byxlk/mcupj/docs/微信图片_20210222200703.jpg

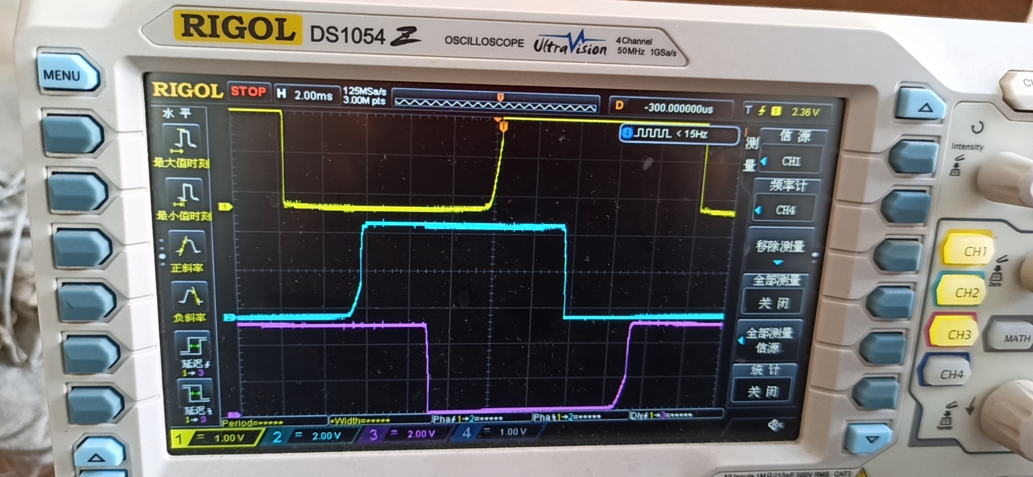
docs/微信图片_20210222200703.jpg
