byxlk/mcupj/docs/微信图片_20210222200711.jpg

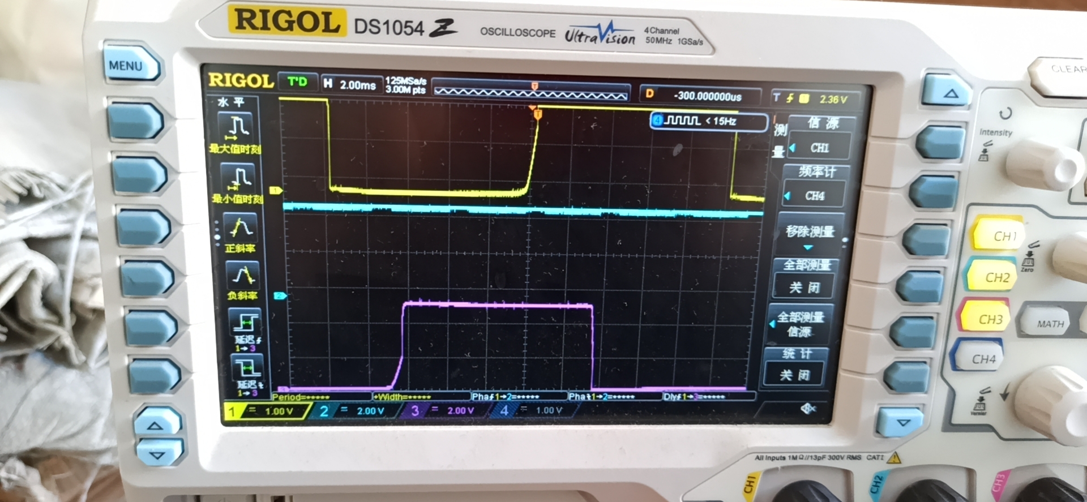
docs/微信图片_20210222200711.jpg
