byxlk/mcupj/docs/微信图片_20210222200650.jpg

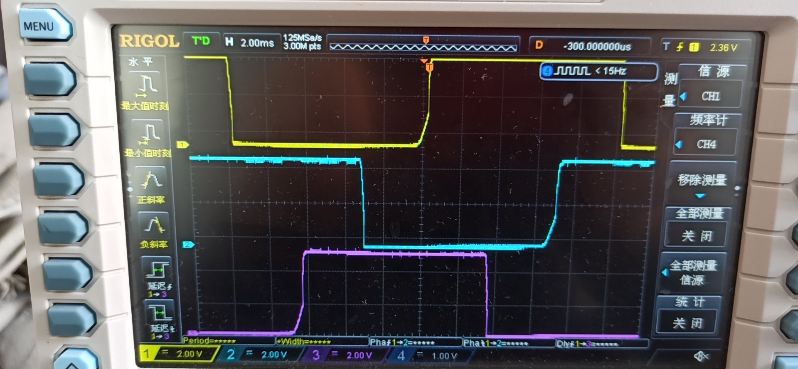
docs/微信图片_20210222200650.jpg
