byxlk/mcupj/docs/sch/分机一控-20200818.pdf

# 分机1控

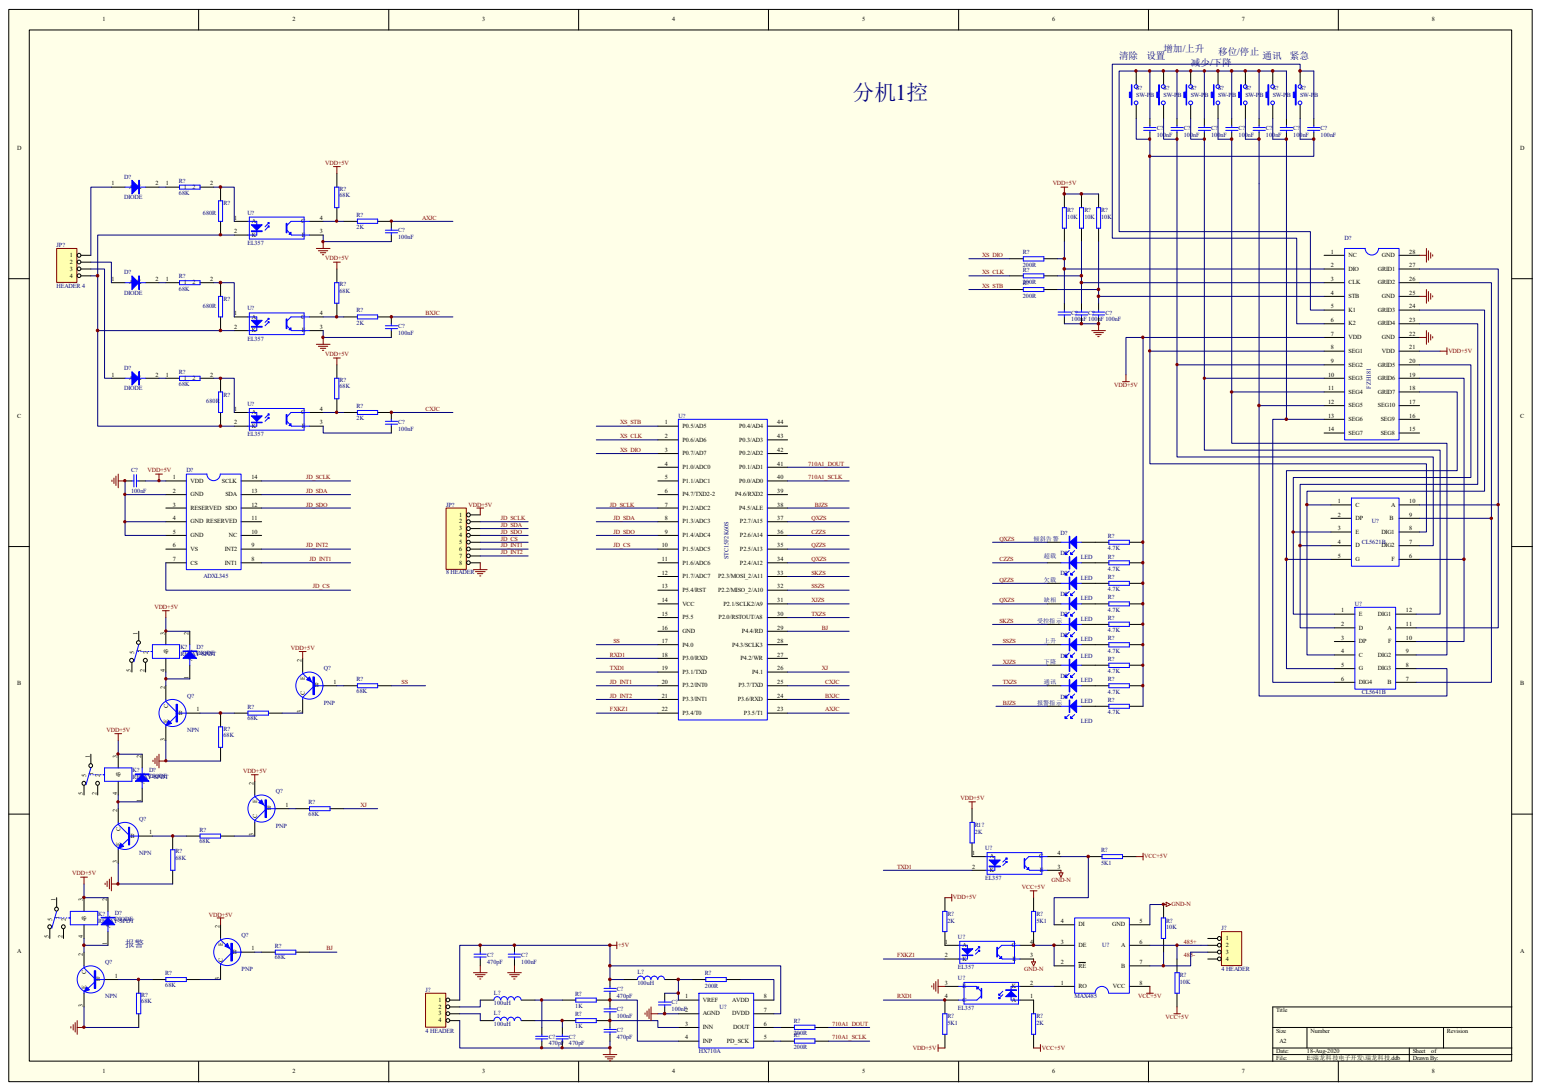
[picture p5: page 1]
Title; Size; Number; Revision; Date:; 18-Aug-2020; Sheet of; File:; E:\瑞龙科技电子开发\瑞龙科技.ddb; Drawn By:; VREF; AGND; INN; INP; PD_SCK; DOUT; DVDD; AVDD; 4 HEADER; GND-N; GND; VCC; MAX485; VCC+5V; VDD+5V; DIODE; HEADER 4; PNP; K? RELAY-SPDT; NPN; D? DIODE; DIG2; DIG1; DIO; CLK; STB; VDD; SEG1; SEG2; SEG3; SEG4; SEG5; SEG6; SEG7; SEG8; SEG9; SEG10; GRID7; GRID6; GRID5; GRID4; GRID3; GRID2; GRID1; FZH181; DIG4; DIG3; XS_DIO; FXKZ1; RXD1; TXD1; AXJC; BXJC; CXJC; 710A1_SCLK; 710A1_DOUT; P1.0/ADC0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
