byxlk/mcupj/docs/sch/分机一控二-20200818.pdf

# 分机1控2

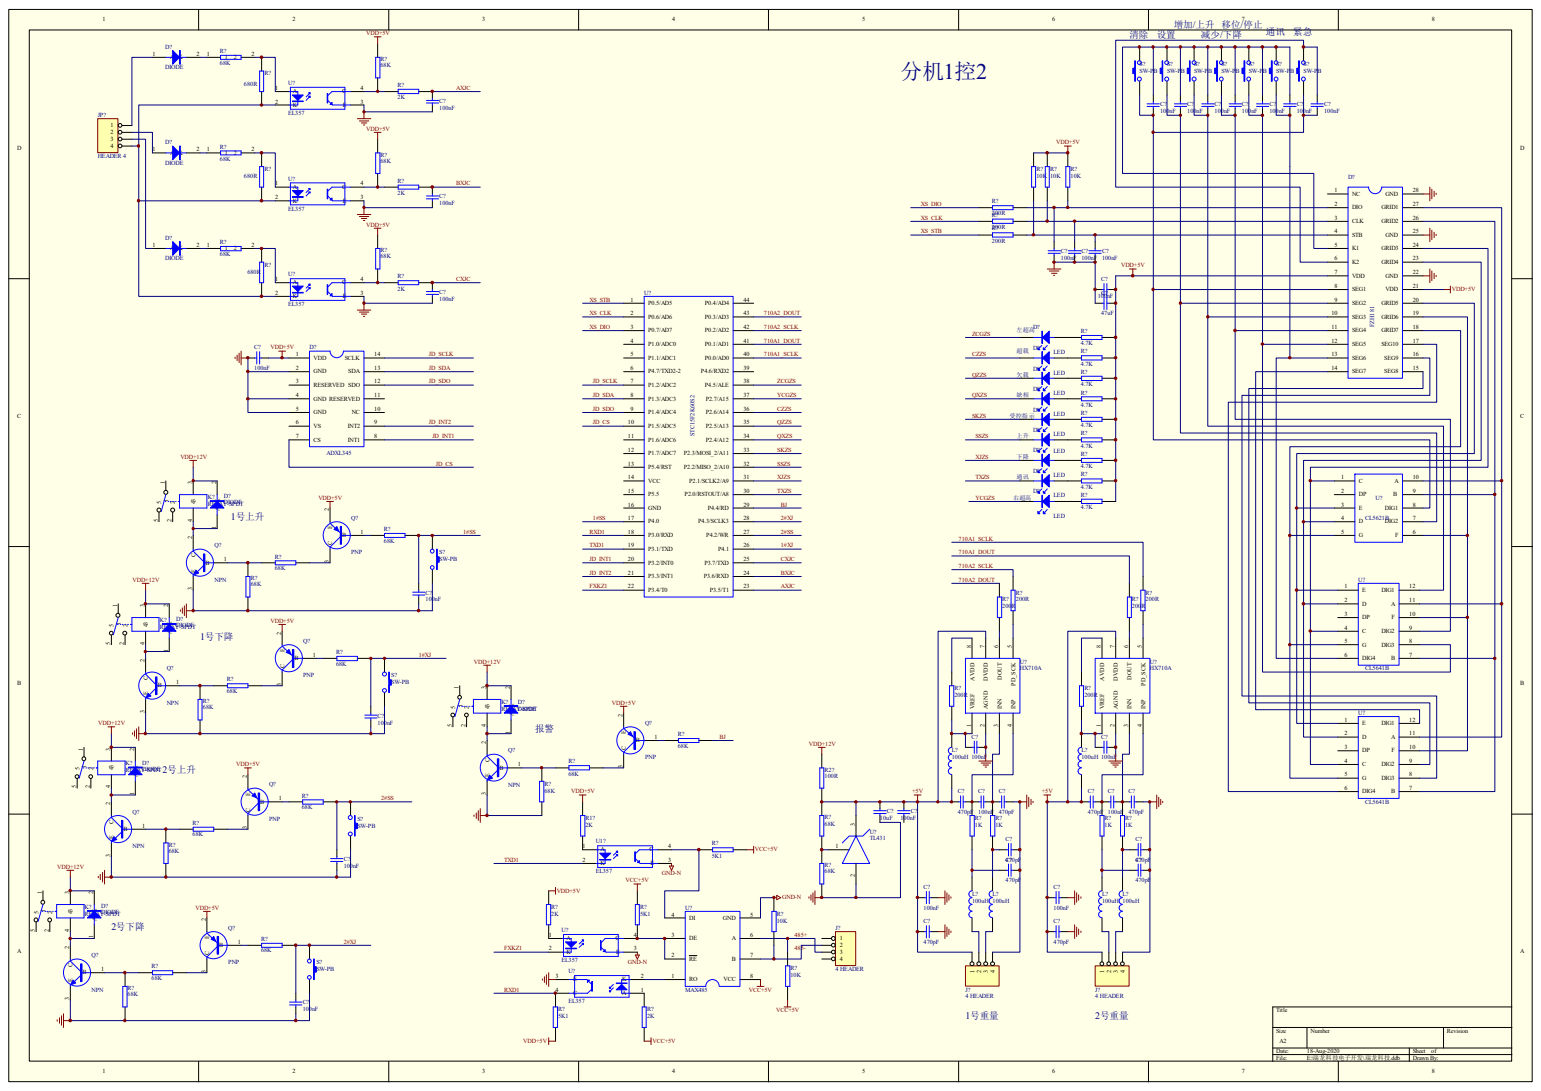
[picture p6: page 1]
Title; Size; Number; Revision; Date:; 18-Aug-2020; Sheet of; File:; E:\瑞龙科技电子开发\瑞龙科技.ddb; Drawn By:; LED; 左超高; 受控指示; 右超高; DIODE; VDD+5V; HEADER 4; VDD+12V; VREF; AGND; INN; INP; PD_SCK; DOUT; DVDD; AVDD; J? 4 HEADER; PNP; K? RELAY-SPDT; NPN; D? DIODE; GND-N; GND; VCC; MAX485; VCC+5V; 4 HEADER; 1号上升; 1号下降; 2号上升; 2号下降; 1号重量; 2号重量; DIG2; DIG1; DIO; CLK; STB; VDD; SEG1; SEG2; SEG3; SEG4; SEG5; SEG6; SEG7; SEG8; SEG9; SEG10; GRID7; GRID6; GRID5; GRID4; GRID3; GRID2; GRID1; FZH181; DIG4; DIG3; CZZS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
