byxlk/mcupj/docs/sch/主机-20210122.pdf

主主

## 增增/上上 移移/同同同同

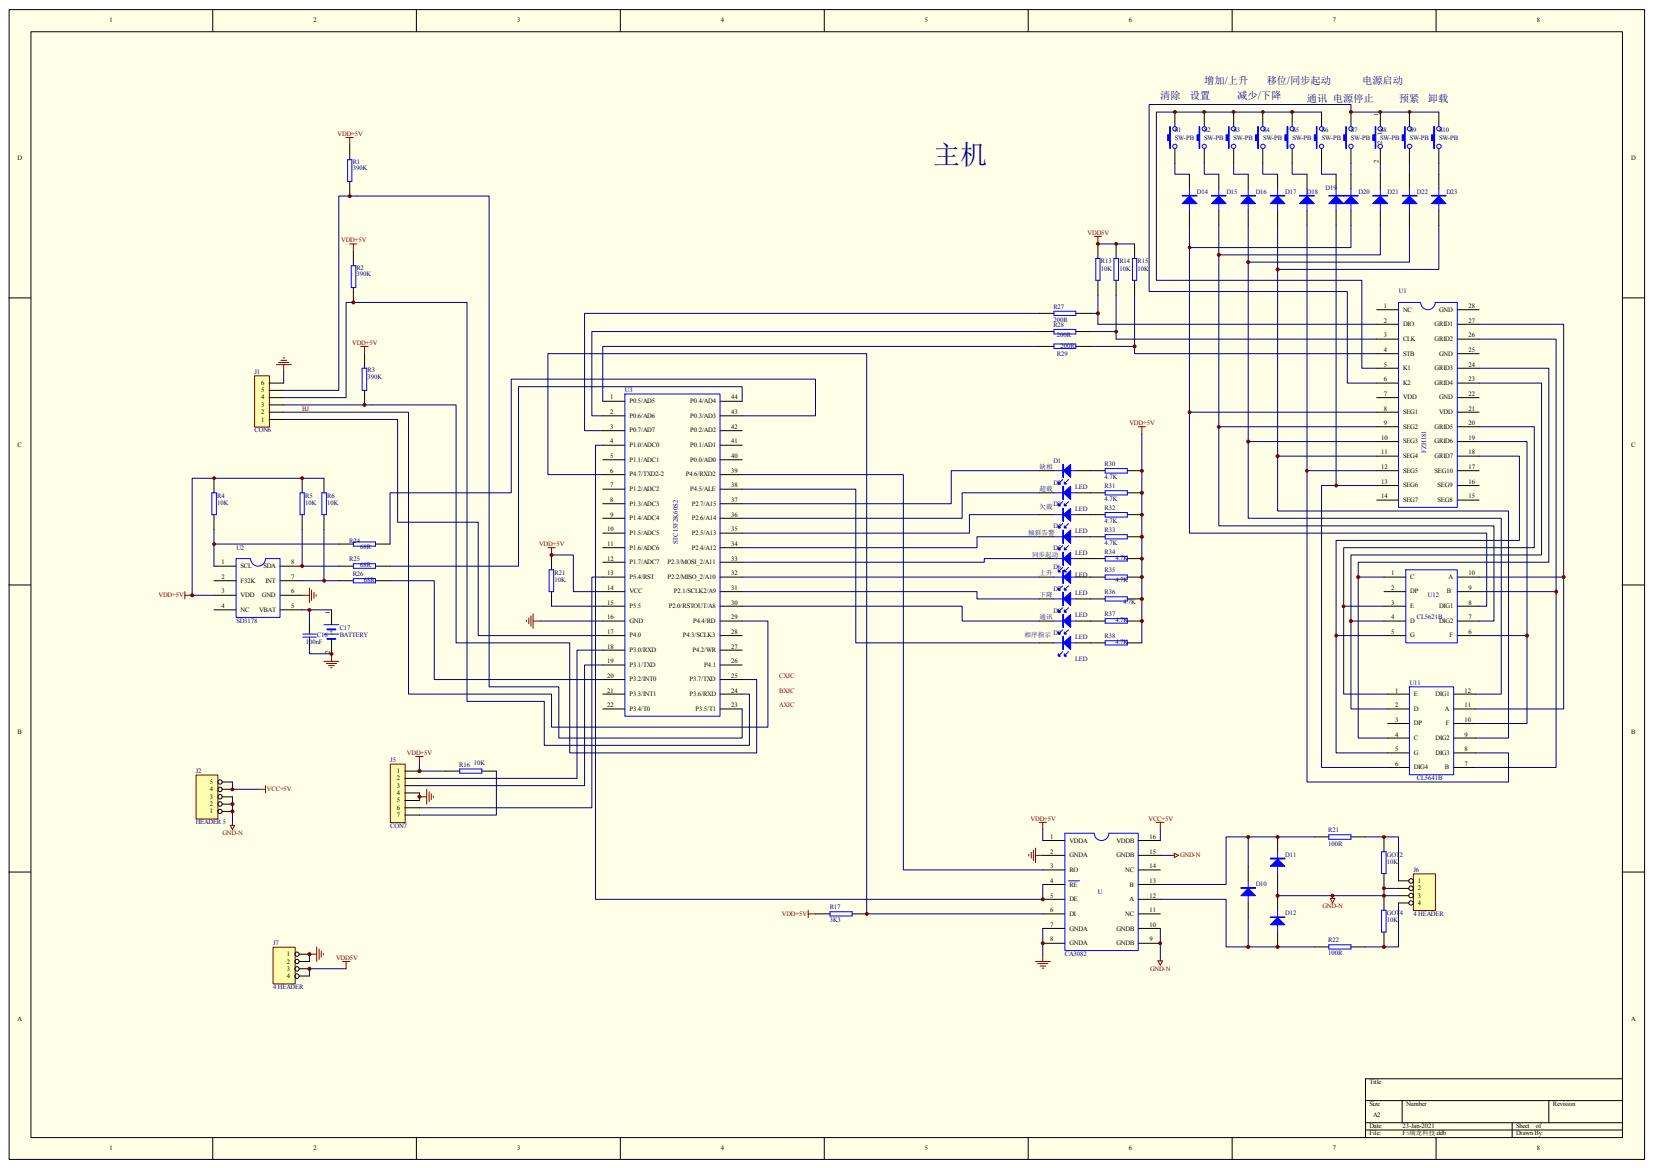
[picture p7: page 1]
