byxlk/mcupj/docs/sch/分机-20210122.pdf

## 增增/上上 移移/停停 减减/下下

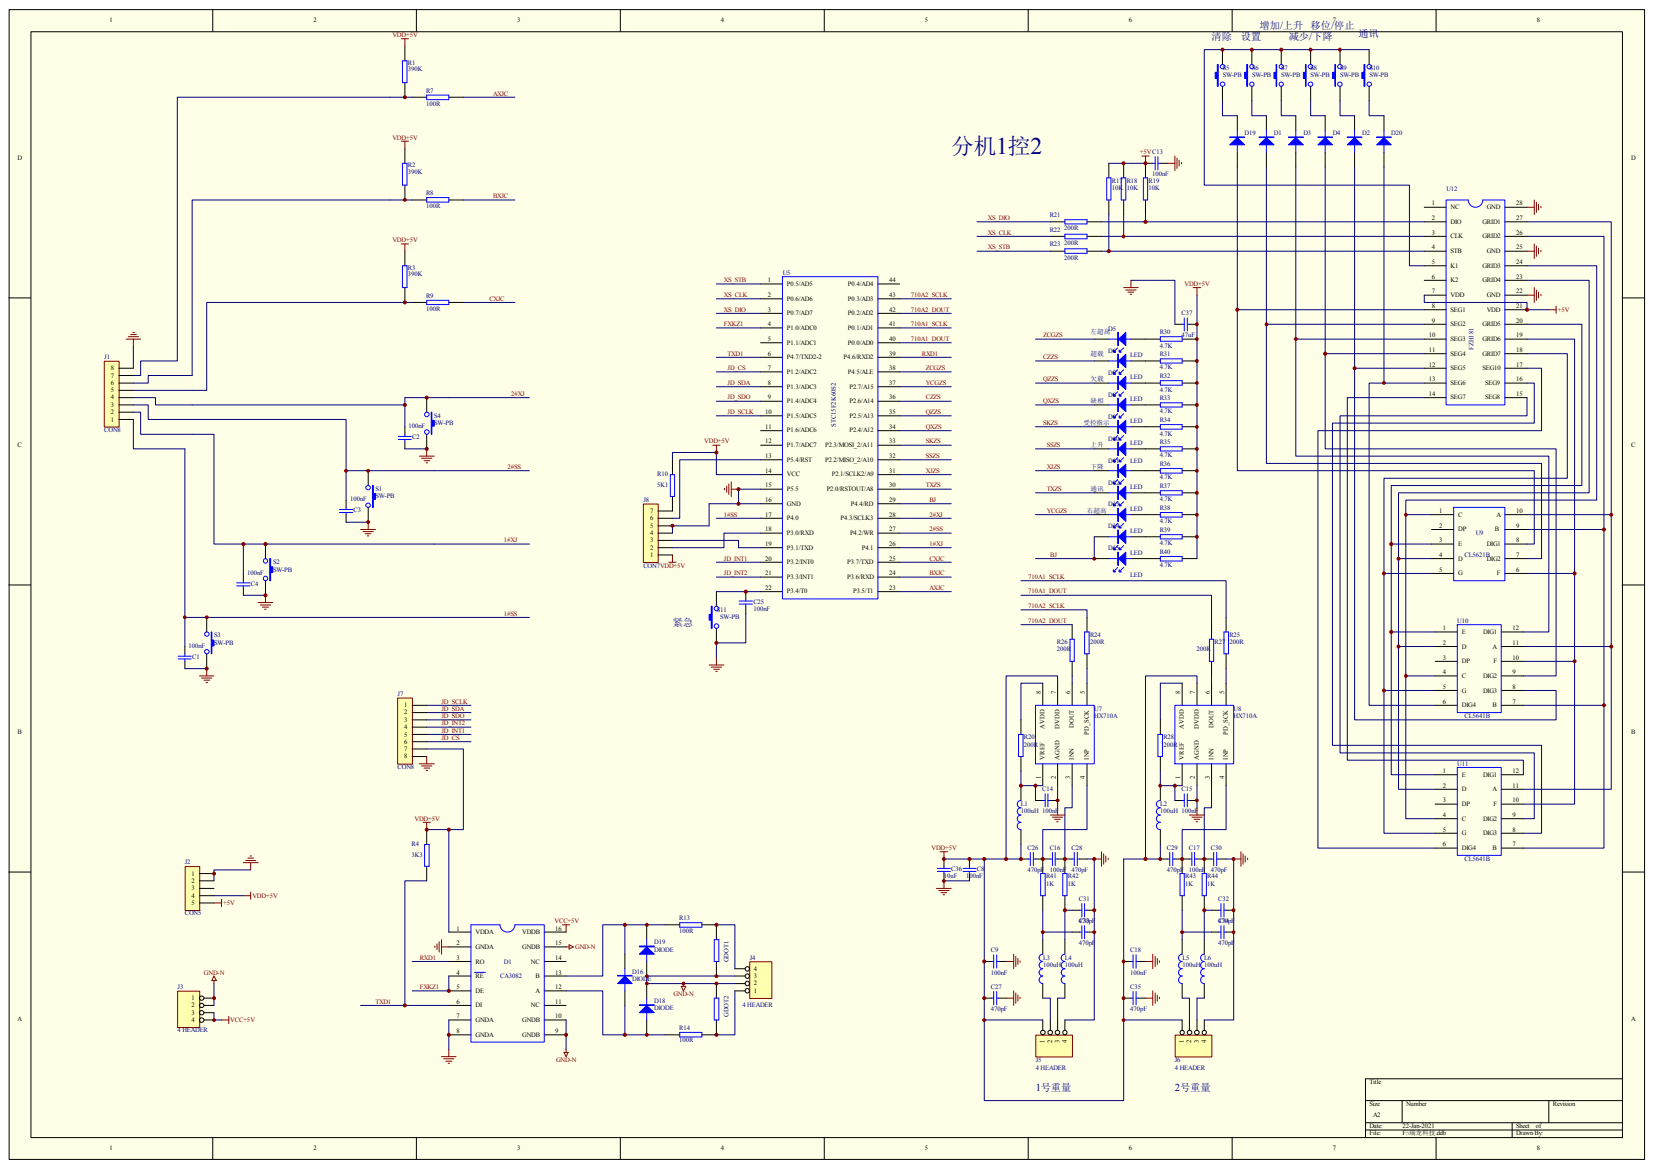
[picture p8: page 1]
