byxlk/mcupj/docs/sch/主机修改后图-20201230.pdf

主主

## 增增/上上 移移/同同同同

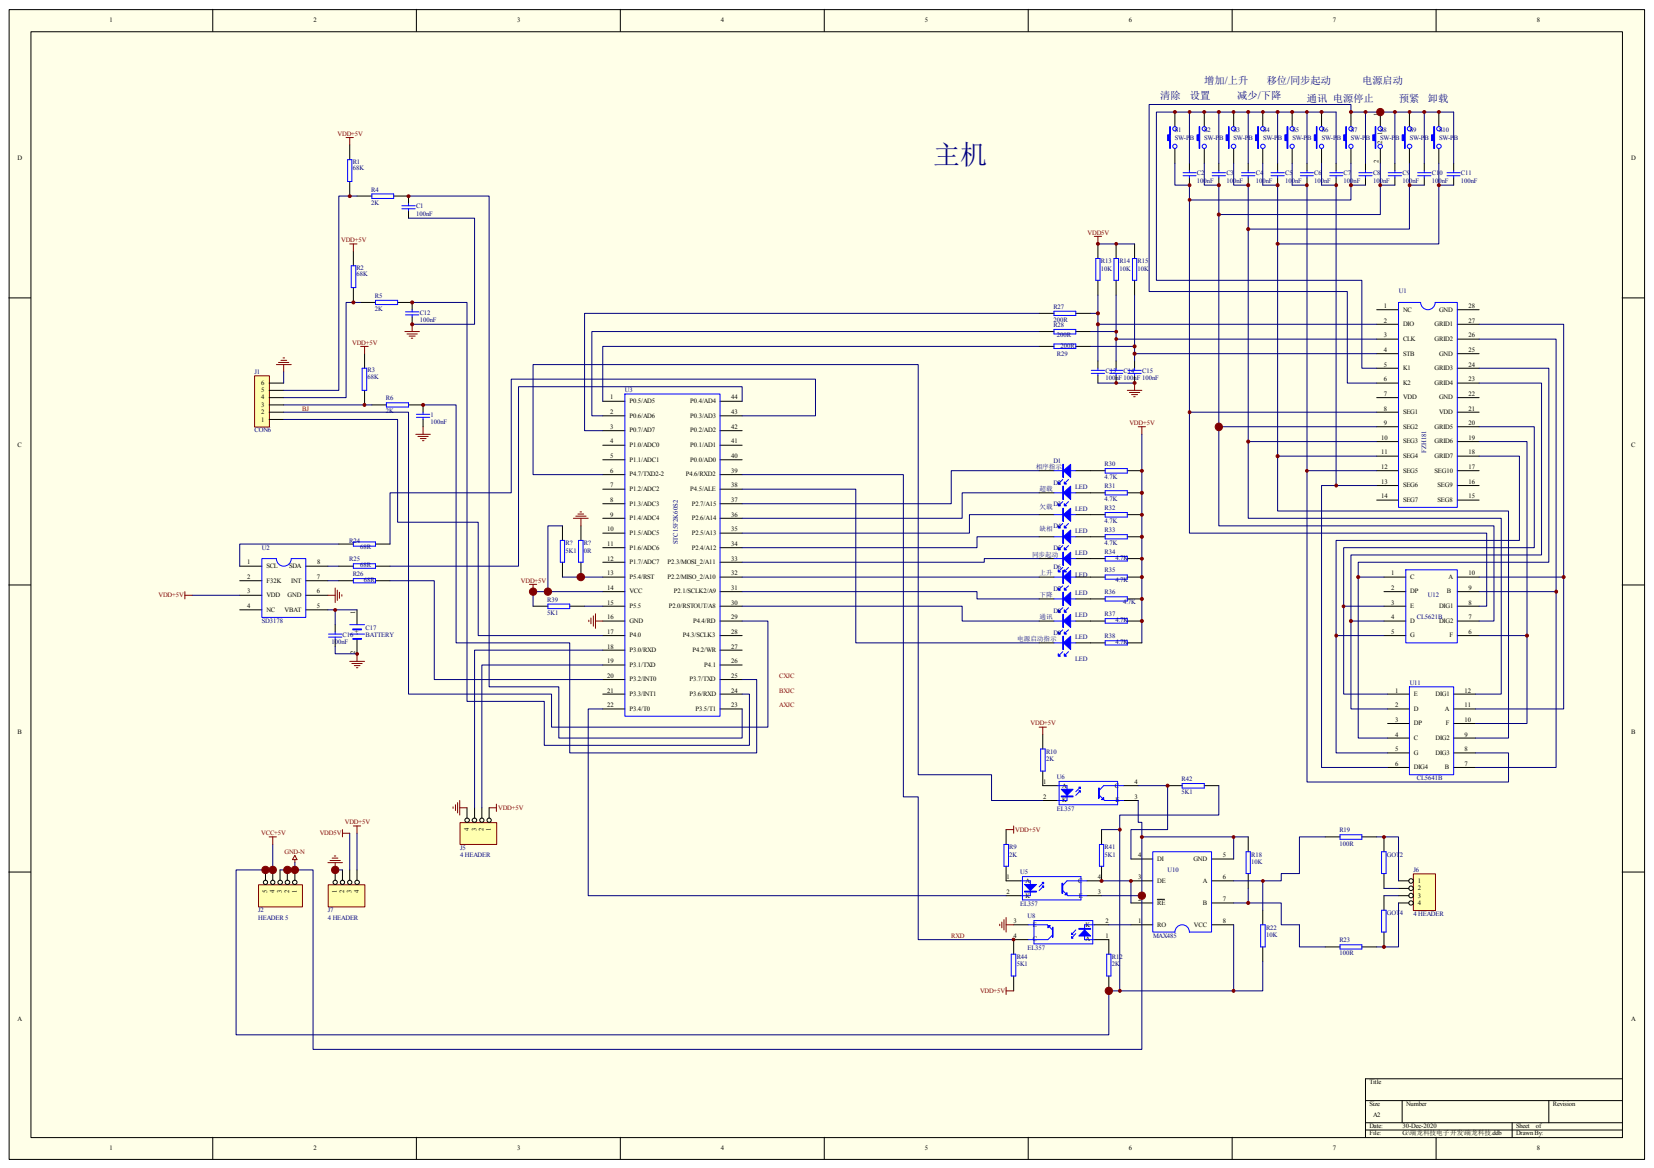
[picture p9: page 1]
