byxlk/mcupj/docs/sch/分机修改后图-20201230.pdf

## 增增/上上 移移/停停 减减/下下 通通 紧紧

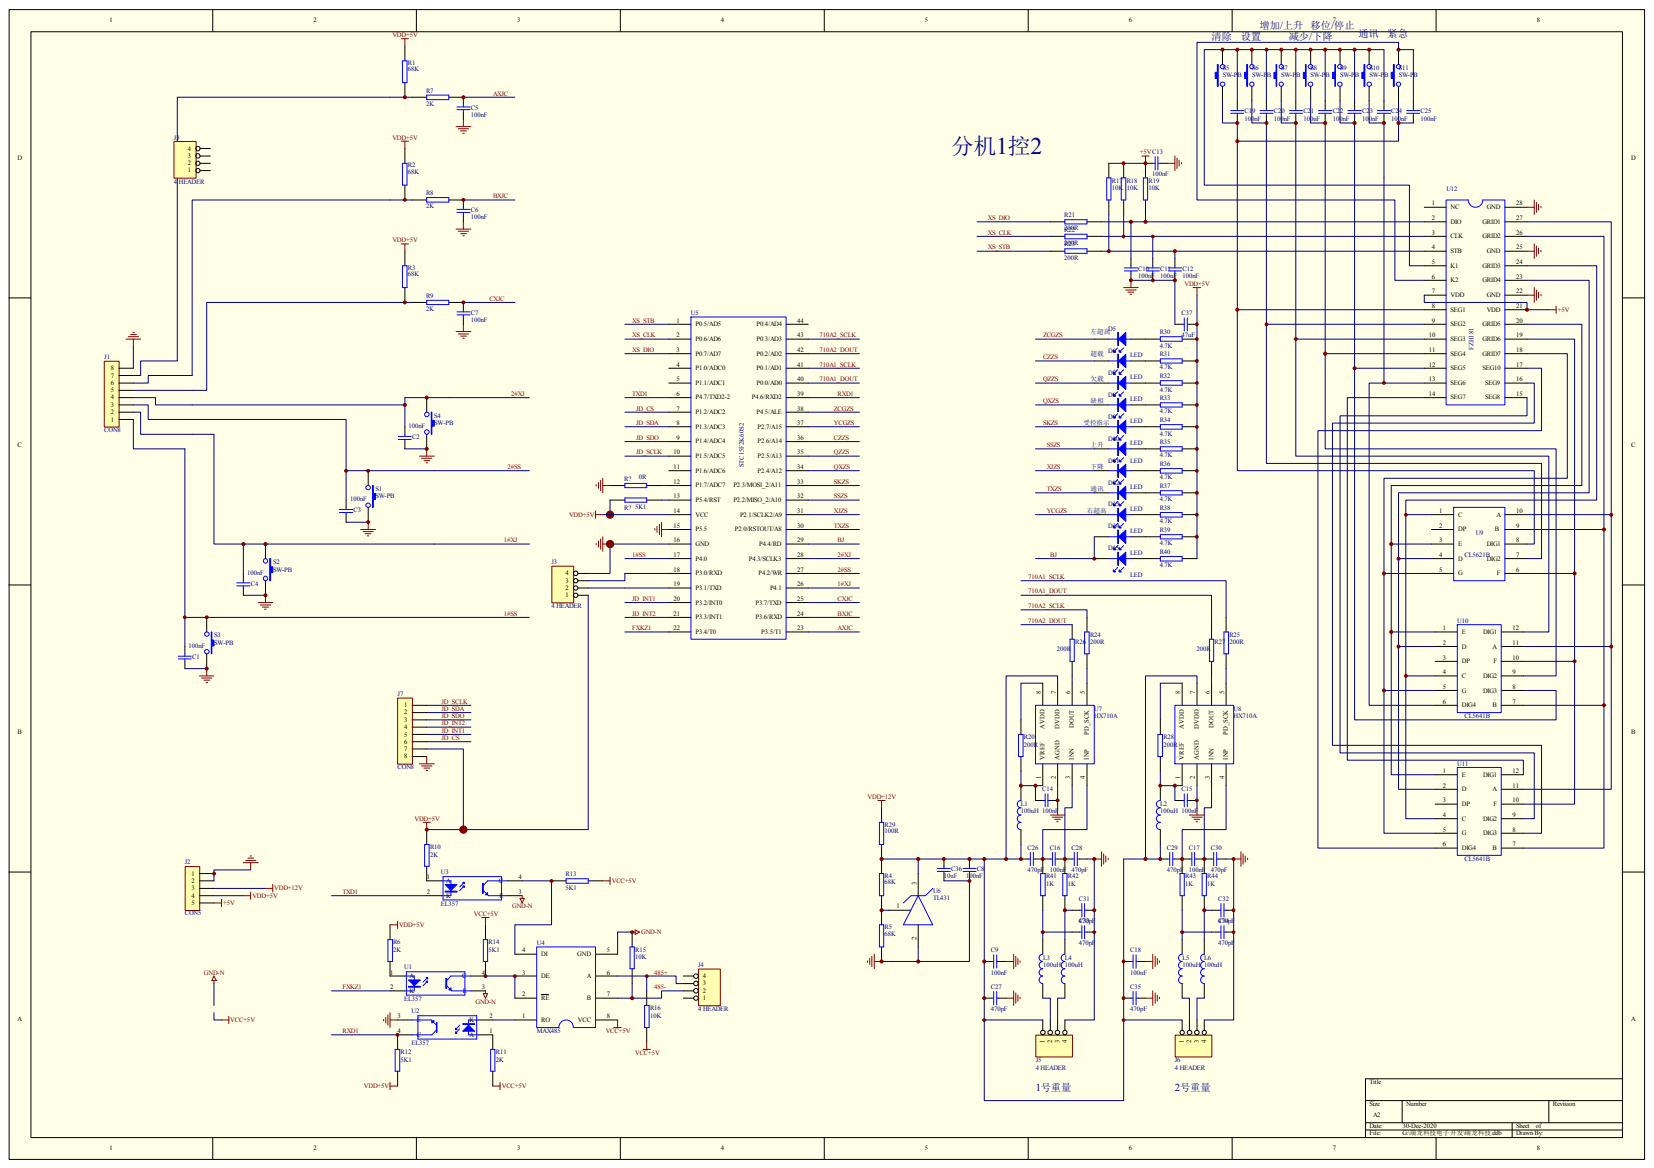
[picture p10: page 1]
