byxlk/mcupj/docs/sch/爬架主机-20201211.pdf

主主

## 增增/上上 移移/同同同同

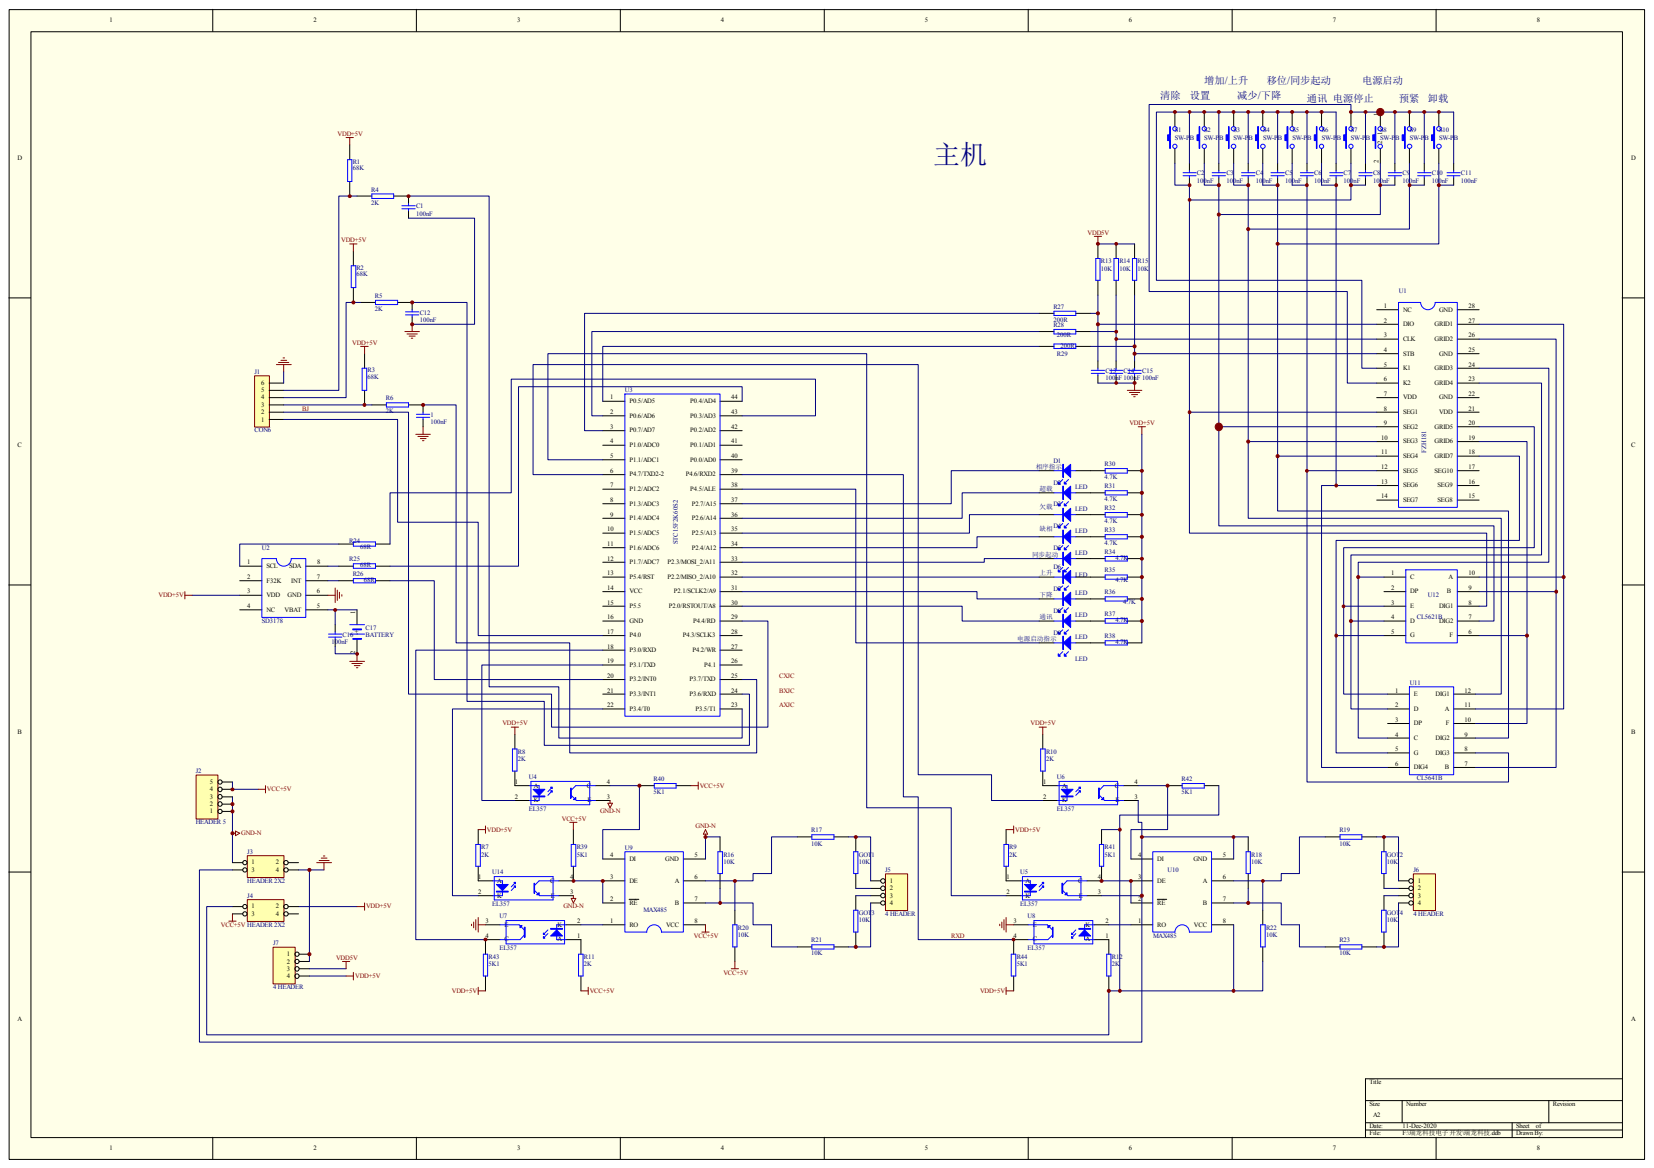
[picture p11: page 1]
