byxlk/mcupj/docs/sch/爬架分机一控二原理图-20201211.pdf

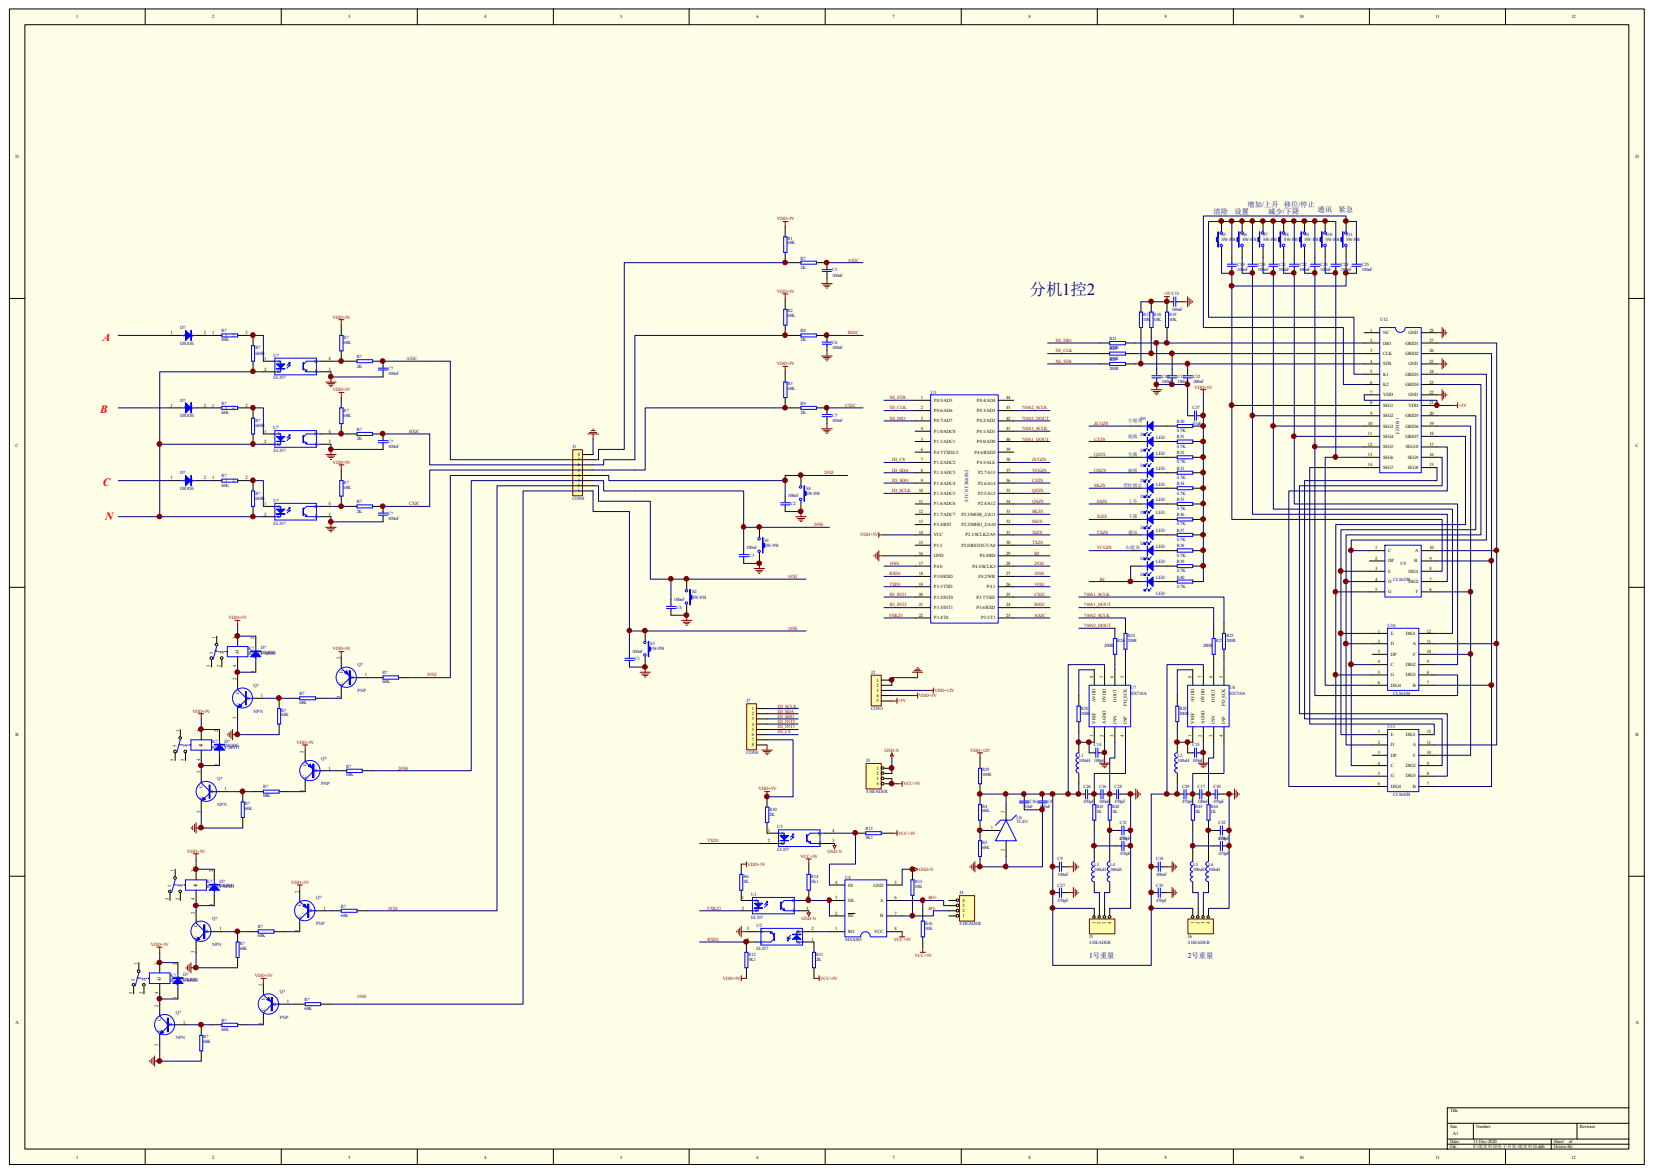
[picture p12: page 1]
