byxlk/mcupj/docs/sch/主机-20200818.pdf

主

机

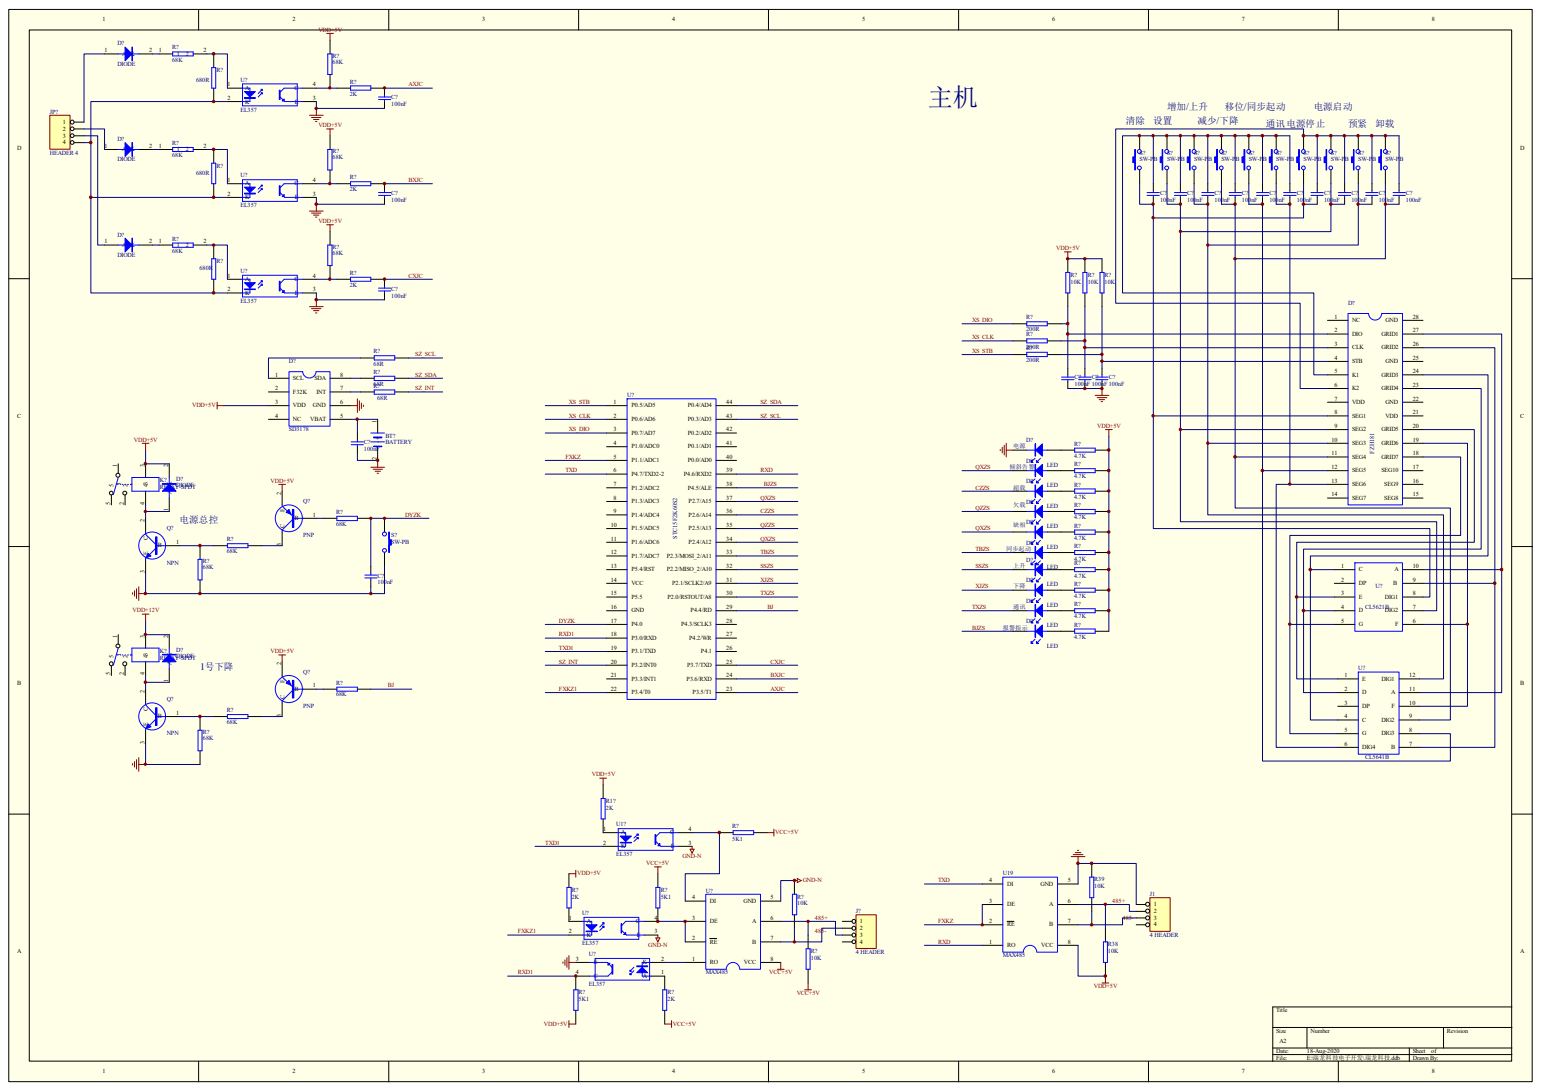
[picture p13: page 1]
ABCD; DCBA; A2 Date :; ddb; awn; MAX4; LAY; ? MAX4; RID; FZH181; XKZ; RXD; TXD; YZK AXJC BXJC CXJC; XJZ; TXZ; ALE; STC15F2K60S2; AXJ; YZK TXD; ATTE

TXD RXD FXKZ
