byxlk/mcupj/docs/sch/old_sch_20200812/PJFJ1K.pdf

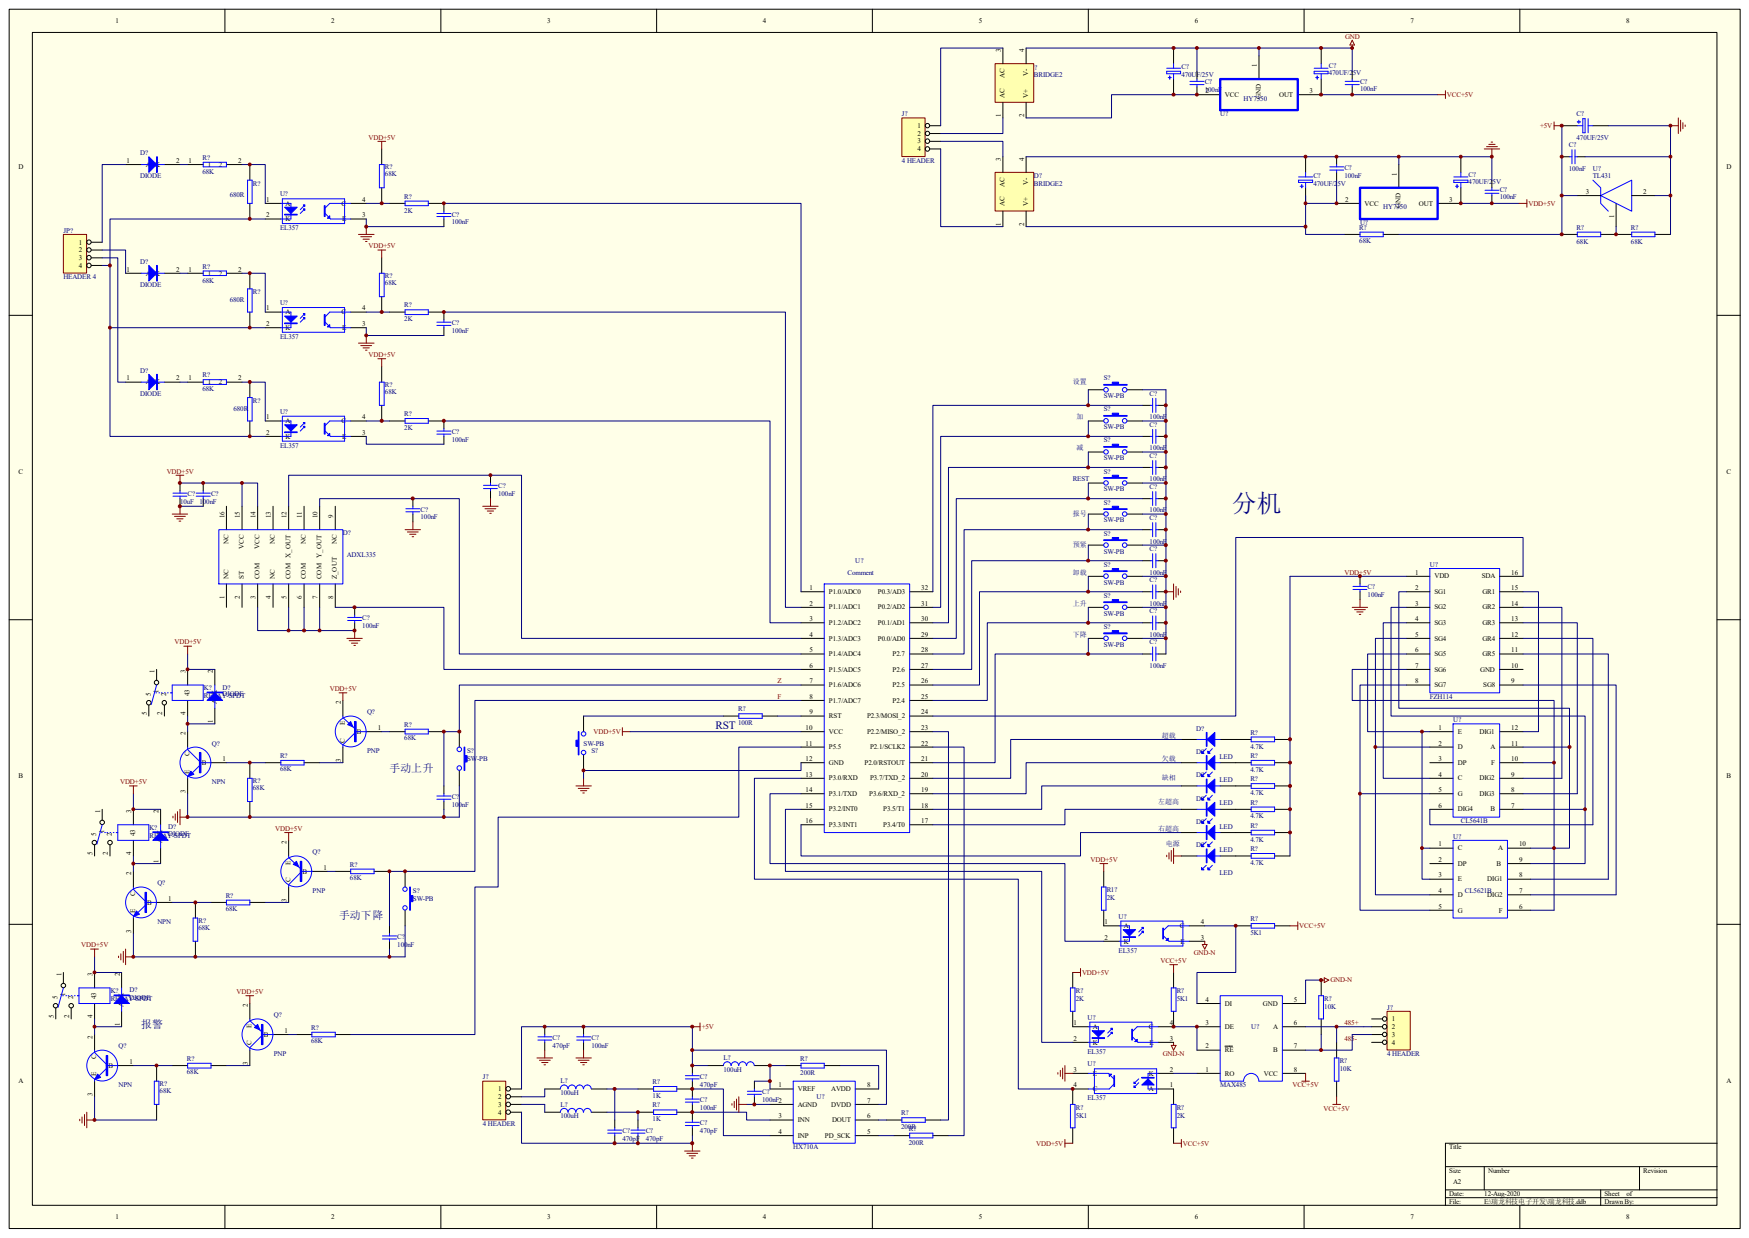
[picture p14: page 1]
Title; Size; Number; Revision; Date:; 12-Aug-2020; Sheet of; File:; E:\瑞龙科技电子开发\瑞龙科技.ddb; Drawn By:; VREF; AGND; INN; INP; PD_SCK; DOUT; DVDD; AVDD; 4 HEADER; GND; VCC; OUT; ？ BRIDGE2; D？ BRIDGE2; VCC+5V; VDD+5V; DIG4; DIG3; DIG2; DIG1; VDD; SDA; FZH114; GND-N; MAX485; LED; 左超高; 右超高; REST; P1.0/ADC0; P1.1/ADC1; P1.2/ADC2; P1.3/ADC3; P1.4/ADC4; P1.5/ADC5; P1.6/ADC6; P1.7/ADC7; RST; P3.0/RXD; P3.1/TXD; P3.2/INT0; P3.3/INT1; P3.6/RXD_2; P3.7/TXD_2; P2.0/RSTOUT; P2.1/SCLK2; P2.2/MISO_2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
