byxlk/mcupj/docs/sch/old_sch_20200812/PJFJ1K2.pdf

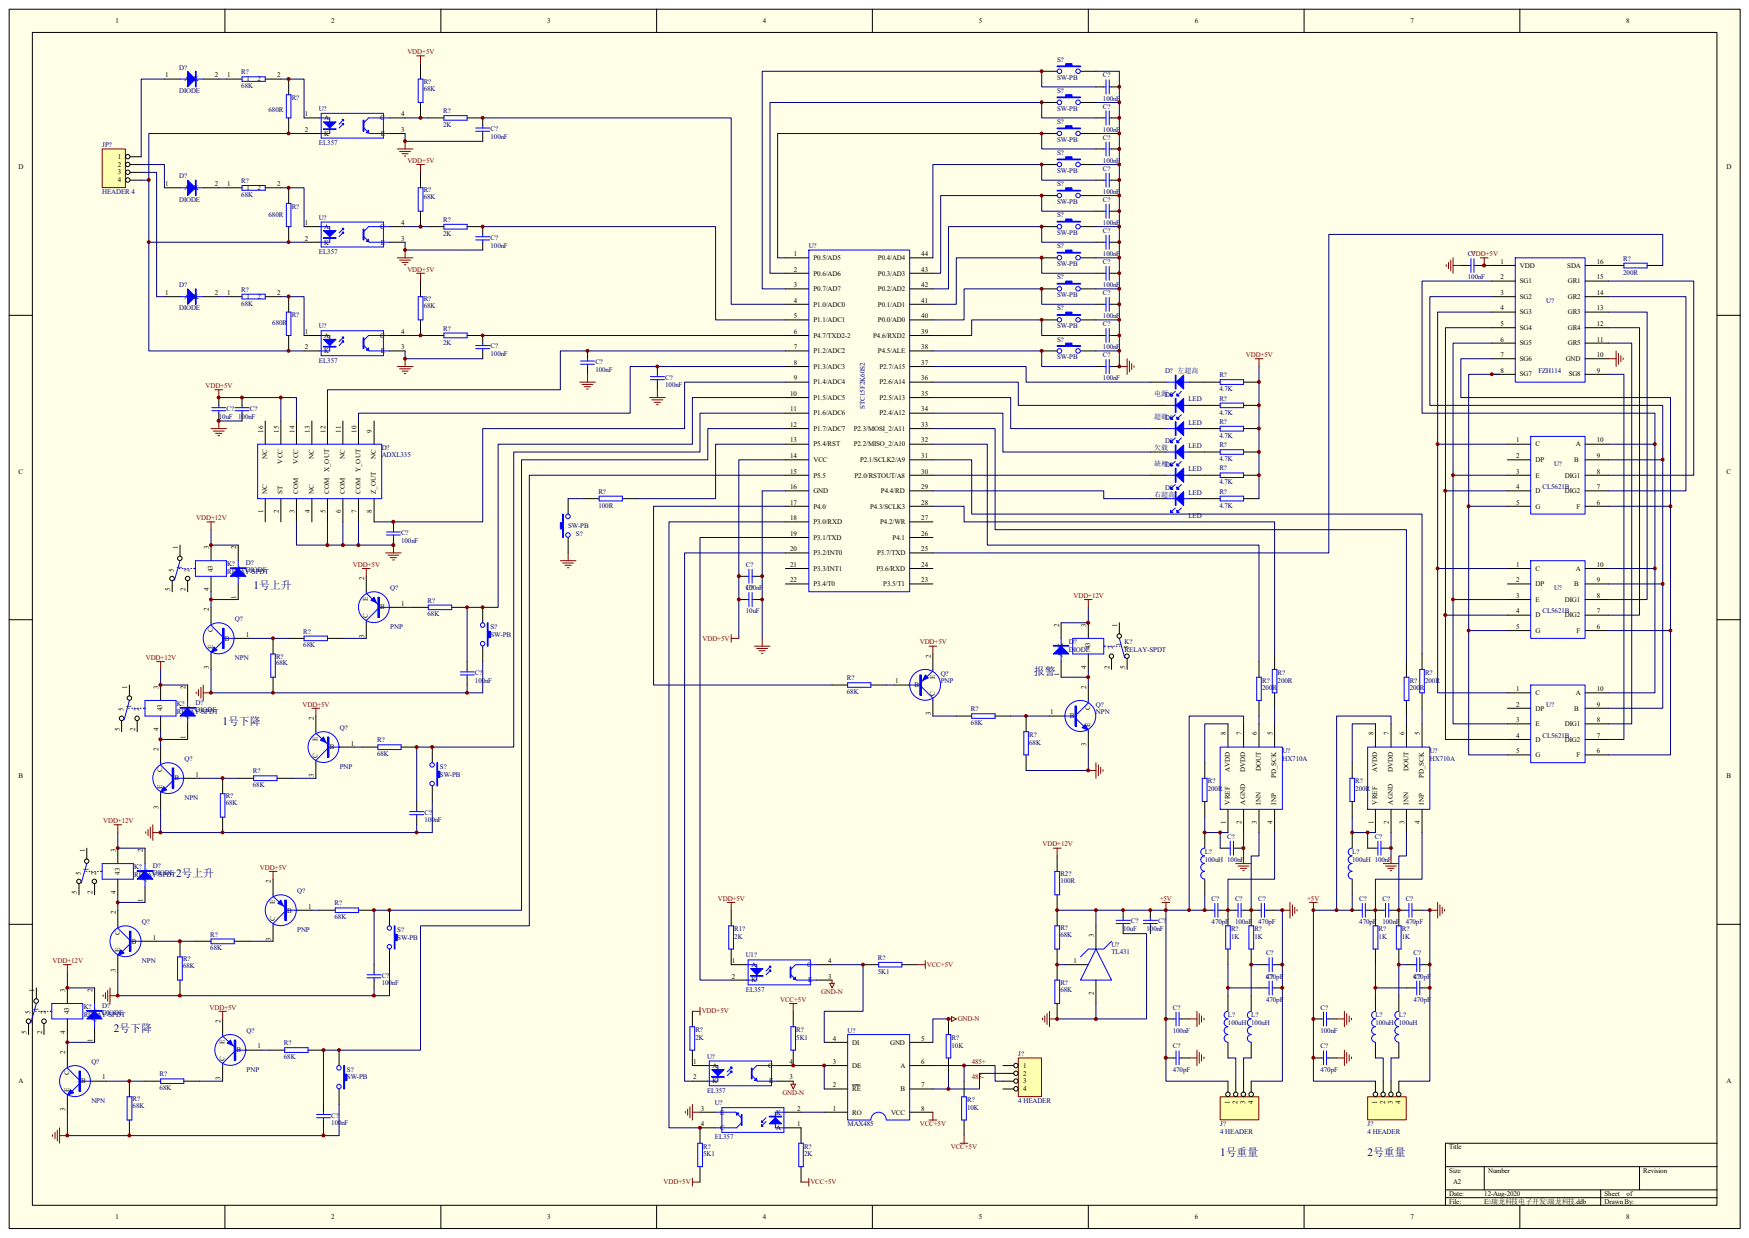
[picture p15: page 1]
Title; Size; Number; Revision; Date:; 12-Aug-2020; Sheet of; File:; E:\瑞龙科技电子开发\瑞龙科技.ddb; Drawn By:; P1.0/ADC0; P1.1/ADC1; P4.7/TXD2-2; P1.2/ADC2; P1.3/ADC3; P1.4/ADC4; P1.5/ADC5; P1.6/ADC6; P1.7/ADC7; P5.4/RST; VCC; GND; P3.0/RXD; P3.1/TXD; P3.2/INT0; P3.3/INT1; P3.6/RXD; P3.7/TXD; P4.3/SCLK3; P2.0/RSTOUT/A8; P2.1/SCLK2/A9; P2.2/MISO_2/A10; P2.3/MOSI_2/A11; P4.5/ALE; P4.6/RXD2; STC15F2K60S2; LED; 左超高; 右超高; DIG2; DIG1; VDD; SDA; FZH114; DIODE; VDD+5V; HEADER 4; VDD+12V; VREF; AGND; INN; INP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
