byxlk/mcupj/docs/sch/old_sch_20200812/PJZJ.pdf

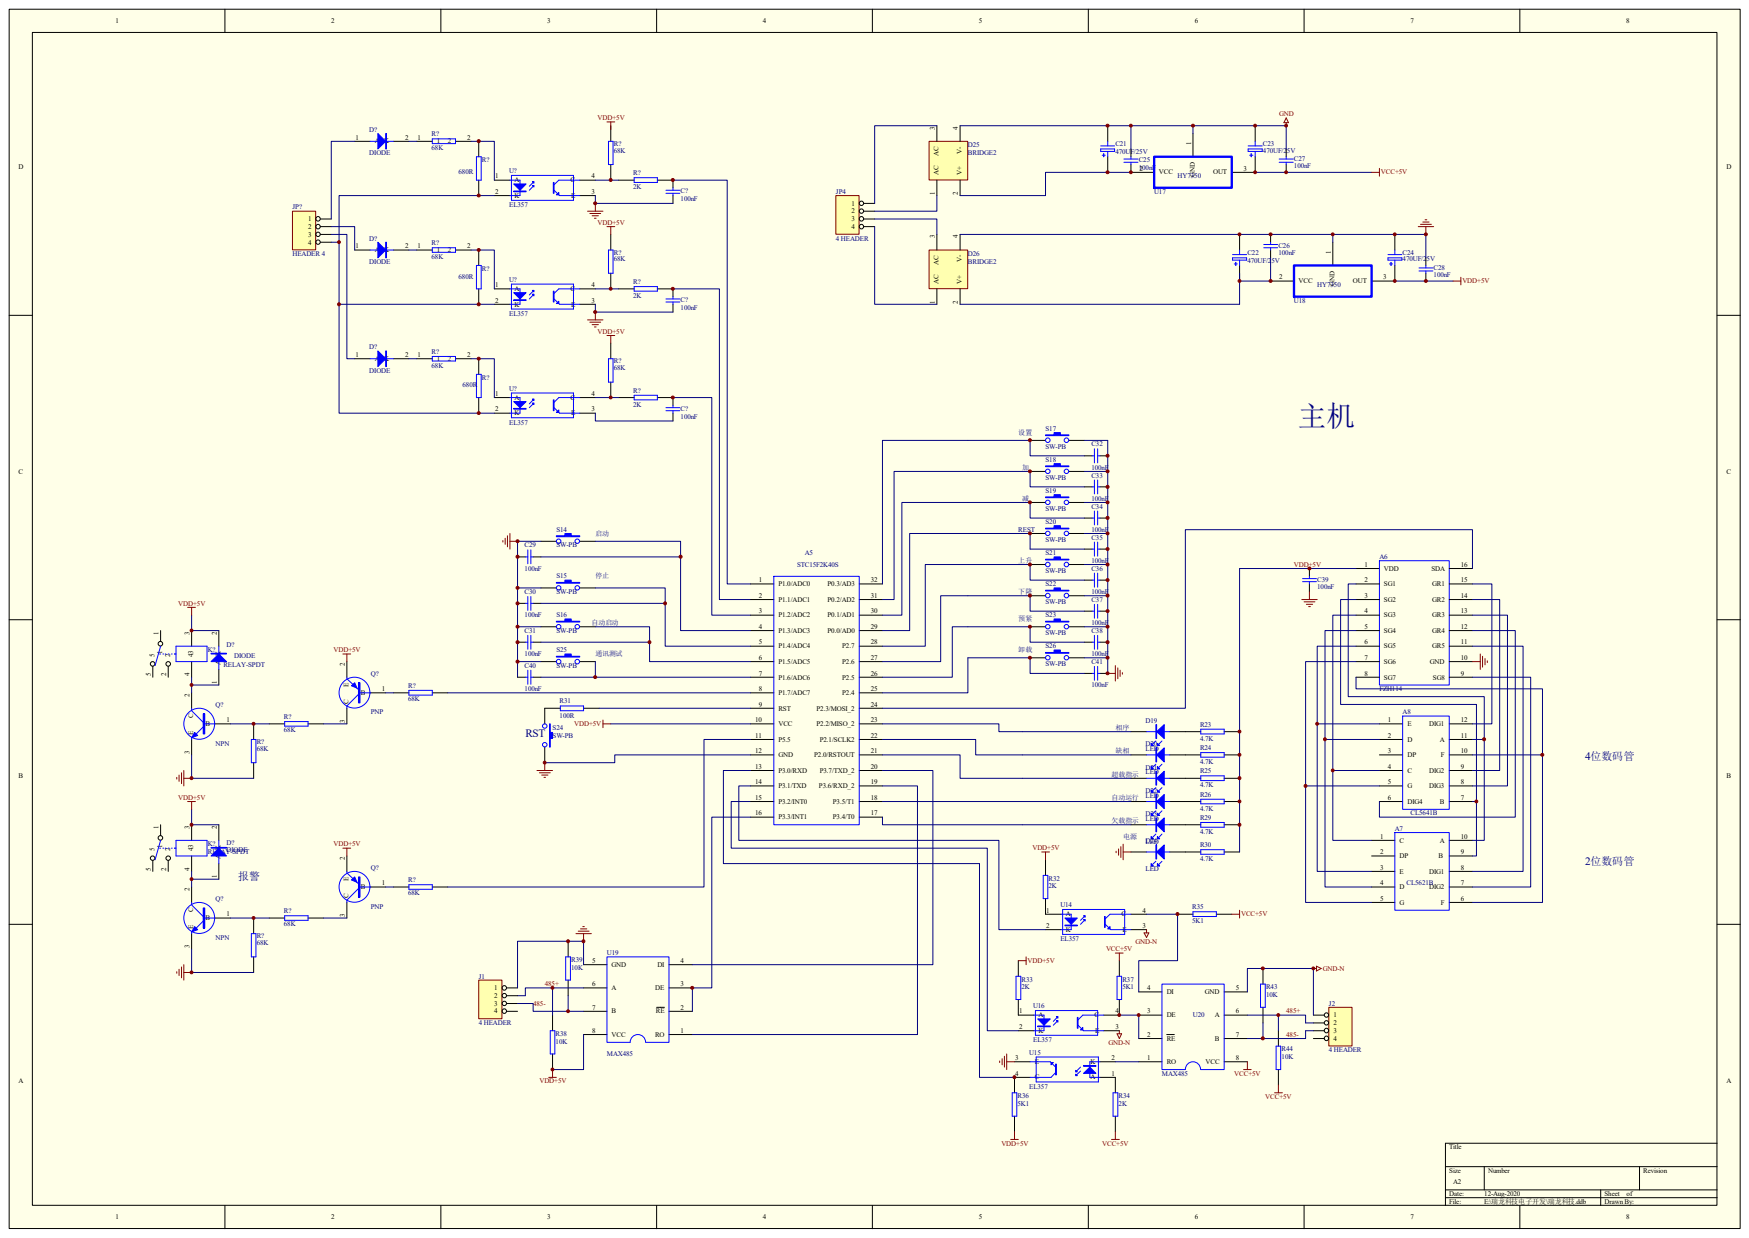
[picture p16: page 1]
ABCD; DCBA; Numb; A2 Date :; Aug; ddb; awn; 置加减REST; GND 1
