byxlk/mcupj/code/main.c

#include "api_config.h"
#include "STC15Fxxxx.H"
#include "USART.h"
#include "GPIO.h"
#include "PCA.h"
#include "timer.h"
#include "ADC.h"
#include "Exti.h"
#include "spi.h"



/*************	本地常量声明	**************/

/*************	本地变量声明	**************/
static u8 sysStatuMachine = STATUSMACHINE_BOOTINIT;
static u16 phaseSeq = 0x0;
static bool bMSR_PowerKeyLock = 1; /* if power key is lock,can't do power up */


/*************	本地函数声明	**************/

/*************  外部函数和变量声明 *****************/

/*************  串口1初始化函数 *****************/
static void UART_config(void)
{
	COMx_InitDefine		COMx_InitStructure;					//结构定义

    /* Debug Uart Config */
	COMx_InitStructure.UART_Mode      = UART_8bit_BRTx;		//模式,       UART_ShiftRight,UART_8bit_BRTx,UART_9bit,UART_9bit_BRTx
	COMx_InitStructure.UART_BRT_Use   = BRT_Timer2;			//使用波特率,   BRT_Timer1, BRT_Timer2 (注意: 串口2固定使用BRT_Timer2)
	COMx_InitStructure.UART_BaudRate  = 38400ul;			//波特率, 一般 110 ~ 115200
	COMx_InitStructure.UART_RxEnable  = ENABLE;				//接收允许,   ENABLE或DISABLE
	COMx_InitStructure.BaudRateDouble = DISABLE;			//波特率加倍, ENABLE或DISABLE
	COMx_InitStructure.UART_Interrupt = ENABLE;				//中断允许,   ENABLE或DISABLE
	COMx_InitStructure.UART_Polity    = PolityHigh;			//中断优先级, PolityLow,PolityHigh
	COMx_InitStructure.UART_P_SW      = UART1_SW_P30_P31;	//切换端口,   UART1_SW_P30_P31,UART1_SW_P36_P37,UART1_SW_P16_P17(必须使用内部时钟)
	COMx_InitStructure.UART_RXD_TXD_Short = DISABLE;		//内部短路RXD与TXD, 做中继, ENABLE,DISABLE
	USART_Configuration(USART1, &COMx_InitStructure);		//初始化串口1 USART1,USART2

    /* MAX485 Uart Config */
    COMx_InitStructure.UART_Mode      = UART_8bit_BRTx;		//模式,       UART_ShiftRight,UART_8bit_BRTx,UART_9bit,UART_9bit_BRTx
	COMx_InitStructure.UART_BRT_Use   = BRT_Timer2;			//使用波特率,   BRT_Timer1, BRT_Timer2 (注意: 串口2固定使用BRT_Timer2)
    COMx_InitStructure.UART_BaudRate  = 38400ul;	        //波特率,     110 ~ 115200
	COMx_InitStructure.UART_RxEnable  = ENABLE;				//接收允许,   ENABLE或DISABLE
	COMx_InitStructure.UART_Interrupt = ENABLE;				//中断允许,   ENABLE或DISABLE
	COMx_InitStructure.UART_Polity    = PolityHigh;			//中断优先级, PolityLow,PolityHigh
	COMx_InitStructure.UART_P_SW      = UART2_SW_P46_P47;	//切换端口,   UART2_SW_P10_P11,UART2_SW_P46_P47
	USART_Configuration(USART2, &COMx_InitStructure);		//初始化串口2 USART1,USART2
}

void	PCA_config(void)
{
	PCA_InitTypeDef		PCA_InitStructure;

	PCA_InitStructure.PCA_Clock    = PCA_Clock_12T;		//PCA_Clock_1T, PCA_Clock_2T, PCA_Clock_4T, PCA_Clock_6T, PCA_Clock_8T, PCA_Clock_12T, PCA_Clock_Timer0_OF, PCA_Clock_ECI
	PCA_InitStructure.PCA_IoUse    = PCA_P34_P35_P36_P37;	//PCA_P12_P11_P10_P37, PCA_P34_P35_P36_P37, PCA_P24_P25_P26_P27
	PCA_InitStructure.PCA_Interrupt_Mode = ENABLE;		//ENABLE, DISABLE
	PCA_InitStructure.PCA_Polity   = PolityHigh;		//优先级设置	PolityHigh,PolityLow
	PCA_InitStructure.PCA_RUN      = DISABLE;			//ENABLE, DISABLE
	PCA_Init(PCA_Counter,&PCA_InitStructure);

	PCA_InitStructure.PCA_Mode     = PCA_Mode_Capture;		//PCA_Mode_PWM, PCA_Mode_Capture, PCA_Mode_SoftTimer, PCA_Mode_HighPulseOutput
	PCA_InitStructure.PCA_PWM_Wide = 0;		//PCA_PWM_8bit, PCA_PWM_7bit, PCA_PWM_6bit
	PCA_InitStructure.PCA_Interrupt_Mode = PCA_Fall_Active | ENABLE;		//PCA_Rise_Active, PCA_Fall_Active, ENABLE, DISABLE
	PCA_InitStructure.PCA_Value    = 0;			//对于PWM,高8位为PWM占空比
	PCA_Init(PCA0,&PCA_InitStructure);

	PCA_InitStructure.PCA_Mode     = PCA_Mode_Capture;	//PCA_Mode_PWM, PCA_Mode_Capture, PCA_Mode_SoftTimer, PCA_Mode_HighPulseOutput
	PCA_InitStructure.PCA_PWM_Wide = 0;					//PCA_PWM_8bit, PCA_PWM_7bit, PCA_PWM_6bit
	PCA_InitStructure.PCA_Interrupt_Mode = PCA_Fall_Active | ENABLE;	//(PCA_Rise_Active, PCA_Fall_Active) or (ENABLE, DISABLE)
	PCA_InitStructure.PCA_Value    = 0;					//对于捕捉, 这个值没意义
	PCA_Init(PCA1,&PCA_InitStructure);

	PCA_InitStructure.PCA_Mode     = PCA_Mode_Capture;	//PCA_Mode_PWM, PCA_Mode_Capture, PCA_Mode_SoftTimer, PCA_Mode_HighPulseOutput
	PCA_InitStructure.PCA_PWM_Wide = 0;					//PCA_PWM_8bit, PCA_PWM_7bit, PCA_PWM_6bit
	PCA_InitStructure.PCA_Interrupt_Mode = PCA_Fall_Active | ENABLE;		//PCA_Rise_Active, PCA_Fall_Active, ENABLE, DISABLE
	PCA_InitStructure.PCA_Value    = 0;				//对于软件定时, 为匹配比较值
	PCA_Init(PCA2,&PCA_InitStructure);

	CR = 1;
}

/******************** IO配置函数 **************************/
static void MSR_SLV_CheckGpioConfig(void)
{
    GPIO_InitTypeDef	GPIO_InitStructure;		            //结构定义

    GPIO_InitStructure.Pin  = GPIO_Pin_4 | GPIO_Pin_5;     //指定要初始化的IO, GPIO_Pin_0 ~ GPIO_Pin_7, 或操作
	GPIO_InitStructure.Mode = GPIO_HighZ;		           //指定IO的输入或输出方式,GPIO_PullUp,GPIO_HighZ,GPIO_OUT_OD,GPIO_OUT_PP
	GPIO_Inilize(GPIO_P5,&GPIO_InitStructure);
}
static void MSR_GPIO_Config(void)
{
	GPIO_InitTypeDef	GPIO_InitStructure;		            //结构定义

    GPIO_InitStructure.Pin  = GPIO_Pin_3 | GPIO_Pin_5 | GPIO_Pin_6;	   //指定要初始化的IO, GPIO_Pin_0 ~ GPIO_Pin_7, 或操作
	GPIO_InitStructure.Mode = GPIO_OUT_PP;		           //指定IO的输入或输出方式,GPIO_PullUp,GPIO_HighZ,GPIO_OUT_OD,GPIO_OUT_PP
	GPIO_Inilize(GPIO_P0,&GPIO_InitStructure);	           //初始化

    GPIO_InitStructure.Pin  = GPIO_Pin_4 | GPIO_Pin_7;	   //指定要初始化的IO, GPIO_Pin_0 ~ GPIO_Pin_7, 或操作
	GPIO_InitStructure.Mode = GPIO_PullUp;		           //指定IO的输入或输出方式,GPIO_PullUp,GPIO_HighZ,GPIO_OUT_OD,GPIO_OUT_PP
	GPIO_Inilize(GPIO_P0,&GPIO_InitStructure);	           //初始化
    
	GPIO_InitStructure.Pin  = GPIO_Pin_1;	               //指定要初始化的IO, GPIO_Pin_0 ~ GPIO_Pin_7, 或操作
	GPIO_InitStructure.Mode = GPIO_OUT_PP;		           //指定IO的输入或输出方式,GPIO_PullUp,GPIO_HighZ,GPIO_OUT_OD,GPIO_OUT_PP
	GPIO_Inilize(GPIO_P1,&GPIO_InitStructure);	           //初始化

    GPIO_InitStructure.Pin  = GPIO_Pin_All;	               //指定要初始化的IO, GPIO_Pin_0 ~ GPIO_Pin_7, 或操作
	GPIO_InitStructure.Mode = GPIO_OUT_PP;		           //指定IO的输入或输出方式,GPIO_PullUp,GPIO_HighZ,GPIO_OUT_OD,GPIO_OUT_PP
	GPIO_Inilize(GPIO_P2,&GPIO_InitStructure);	           //初始化
    
    GPIO_InitStructure.Pin  = GPIO_Pin_4;	               //指定要初始化的IO, GPIO_Pin_0 ~ GPIO_Pin_7, 或操作
	GPIO_InitStructure.Mode = GPIO_OUT_PP;		           //指定IO的输入或输出方式,GPIO_PullUp,GPIO_HighZ,GPIO_OUT_OD,GPIO_OUT_PP
	GPIO_Inilize(GPIO_P3,&GPIO_InitStructure);	           //初始化
    
	//GPIO_InitStructure.Pin  = GPIO_Pin_5 | GPIO_Pin_6 | GPIO_Pin_7;	//指定要初始化的IO, GPIO_Pin_0 ~ GPIO_Pin_7, 或操作
	//GPIO_InitStructure.Mode = GPIO_HighZ;		           //指定IO的输入或输出方式,GPIO_PullUp,GPIO_HighZ,GPIO_OUT_OD,GPIO_OUT_PP
	//GPIO_Inilize(GPIO_P3,&GPIO_InitStructure);	           //初始化

    GPIO_InitStructure.Pin  = GPIO_Pin_4 | GPIO_Pin_5;	   //指定要初始化的IO, GPIO_Pin_0 ~ GPIO_Pin_7, 或操作
	GPIO_InitStructure.Mode = GPIO_OUT_PP;		           //指定IO的输入或输出方式,GPIO_PullUp,GPIO_HighZ,GPIO_OUT_OD,GPIO_OUT_PP
	GPIO_Inilize(GPIO_P4,&GPIO_InitStructure);	           //初始化

    // init output port status
    MSR_WARN_OUTPUT = 0;
    FZH181_PIN_CLK = 1;
    FZH181_PIN_STB = 1;
    
    /* Off All Led */
    MSR_LedStatusCtrl(MSR_LED_ALL, LED_OFF);
}

static void SLV_GPIO_Config(void)
{
	GPIO_InitTypeDef	GPIO_InitStructure;		            //结构定义

    GPIO_InitStructure.Pin  = GPIO_Pin_1 | GPIO_Pin_3 | GPIO_Pin_5 | GPIO_Pin_6;	   //指定要初始化的IO, GPIO_Pin_0 ~ GPIO_Pin_7, 或操作
	GPIO_InitStructure.Mode = GPIO_OUT_PP;		           //指定IO的输入或输出方式,GPIO_PullUp,GPIO_HighZ,GPIO_OUT_OD,GPIO_OUT_PP
	GPIO_Inilize(GPIO_P0,&GPIO_InitStructure);	           //初始化

    GPIO_InitStructure.Pin  = GPIO_Pin_0 | GPIO_Pin_2 | GPIO_Pin_7;	   //指定要初始化的IO, GPIO_Pin_0 ~ GPIO_Pin_7, 或操作
	GPIO_InitStructure.Mode = GPIO_PullUp;		           //指定IO的输入或输出方式,GPIO_PullUp,GPIO_HighZ,GPIO_OUT_OD,GPIO_OUT_PP
	GPIO_Inilize(GPIO_P0,&GPIO_InitStructure);	           //初始化
    
	GPIO_InitStructure.Pin  = GPIO_Pin_1;	               //指定要初始化的IO, GPIO_Pin_0 ~ GPIO_Pin_7, 或操作
	GPIO_InitStructure.Mode = GPIO_OUT_PP;		           //指定IO的输入或输出方式,GPIO_PullUp,GPIO_HighZ,GPIO_OUT_OD,GPIO_OUT_PP
	GPIO_Inilize(GPIO_P1,&GPIO_InitStructure);	           //初始化

    GPIO_InitStructure.Pin  = GPIO_Pin_All;	               //指定要初始化的IO, GPIO_Pin_0 ~ GPIO_Pin_7, 或操作
	GPIO_InitStructure.Mode = GPIO_OUT_PP;		           //指定IO的输入或输出方式,GPIO_PullUp,GPIO_HighZ,GPIO_OUT_OD,GPIO_OUT_PP
	GPIO_Inilize(GPIO_P2,&GPIO_InitStructure);	           //初始化
    
    GPIO_InitStructure.Pin  = GPIO_Pin_4;	               //指定要初始化的IO, GPIO_Pin_0 ~ GPIO_Pin_7, 或操作
	GPIO_InitStructure.Mode = GPIO_OUT_PP;		           //指定IO的输入或输出方式,GPIO_PullUp,GPIO_HighZ,GPIO_OUT_OD,GPIO_OUT_PP
	GPIO_Inilize(GPIO_P3,&GPIO_InitStructure);	           //初始化
    
	//GPIO_InitStructure.Pin  = GPIO_Pin_5 | GPIO_Pin_6 | GPIO_Pin_7;	//指定要初始化的IO, GPIO_Pin_0 ~ GPIO_Pin_7, 或操作
	//GPIO_InitStructure.Mode = GPIO_HighZ;		           //指定IO的输入或输出方式,GPIO_PullUp,GPIO_HighZ,GPIO_OUT_OD,GPIO_OUT_PP
	//GPIO_Inilize(GPIO_P3,&GPIO_InitStructure);	           //初始化

    GPIO_InitStructure.Pin  = GPIO_Pin_0 | GPIO_Pin_1 | GPIO_Pin_2 | GPIO_Pin_3 | GPIO_Pin_4 | GPIO_Pin_5;	   //指定要初始化的IO, GPIO_Pin_0 ~ GPIO_Pin_7, 或操作
	GPIO_InitStructure.Mode = GPIO_OUT_PP;		           //指定IO的输入或输出方式,GPIO_PullUp,GPIO_HighZ,GPIO_OUT_OD,GPIO_OUT_PP
	GPIO_Inilize(GPIO_P4,&GPIO_InitStructure);	           //初始化

	// init output port status
    FZH181_PIN_CLK = 1;
    FZH181_PIN_STB = 1;
    
    /* Off All Led */
    SLV_LedStatusCtrl(SLV_LED_ALL, LED_OFF);
}

static void SLV_SPI_Config(void)
{
	SPI_InitTypeDef		SPI_InitStructure;
	SPI_InitStructure.SPI_Module    = ENABLE;             //SPI启动    ENABLE, DISABLE
	SPI_InitStructure.SPI_SSIG      = DISABLE;			  //片选位     ENABLE, DISABLE
	SPI_InitStructure.SPI_FirstBit  = SPI_MSB;			  //移位方向   SPI_MSB, SPI_LSB
	SPI_InitStructure.SPI_Mode      = SPI_Mode_Slave;	  //主从选择   SPI_Mode_Master, SPI_Mode_Slave
	SPI_InitStructure.SPI_CPOL      = SPI_CPOL_High;      //时钟相位   SPI_CPOL_High,   SPI_CPOL_Low
	SPI_InitStructure.SPI_CPHA      = SPI_CPHA_1Edge;	  //数据边沿   SPI_CPHA_1Edge,  SPI_CPHA_2Edge
	SPI_InitStructure.SPI_Interrupt = ENABLE;			  //中断允许   ENABLE,DISABLE
	SPI_InitStructure.SPI_Speed     = SPI_Speed_16;		  //SPI速度    SPI_Speed_4, SPI_Speed_16, SPI_Speed_64, SPI_Speed_128
	SPI_InitStructure.SPI_IoUse     = SPI_P12_P13_P14_P15; //IO口切换   SPI_P12_P13_P14_P15, SPI_P24_P23_P22_P21, SPI_P54_P40_P41_P43
	SPI_Init(&SPI_InitStructure);
	
	SPI_TxRxMode = SPI_Mode_Slave;
}

/************************ 定时器配置 ****************************/
static void Timer_Config(void)
{
	TIM_InitTypeDef		TIM_InitStructure;					//结构定义
	TIM_InitStructure.TIM_Mode      = TIM_16BitAutoReload;	//指定工作模式,   TIM_16BitAutoReload,TIM_16Bit,TIM_8BitAutoReload,TIM_16BitAutoReloadNoMask
	TIM_InitStructure.TIM_Polity    = PolityHigh;			//指定中断优先级, PolityHigh,PolityLow
	TIM_InitStructure.TIM_Interrupt = ENABLE;				//中断是否允许,   ENABLE或DISABLE
	TIM_InitStructure.TIM_ClkSource = TIM_CLOCK_1T;		//指定时钟源,     TIM_CLOCK_1T,TIM_CLOCK_12T,TIM_CLOCK_Ext
	TIM_InitStructure.TIM_ClkOut    = DISABLE;				//是否输出高速脉冲, ENABLE或DISABLE
	TIM_InitStructure.TIM_Value     = 65536 - (MAIN_Fosc / (1 * 1000));	//初值, 节拍为100HZ(10ms)
	TIM_InitStructure.TIM_Run       = ENABLE;				//是否初始化后启动定时器, ENABLE或DISABLE
	Timer_Inilize(Timer0,&TIM_InitStructure);				//初始化Timer0	  Timer0,Timer1,Timer2
    
    TIM_InitStructure.TIM_Mode      = TIM_16BitAutoReload;	//指定工作模式,   TIM_16BitAutoReload,TIM_16Bit,TIM_8BitAutoReload,TIM_16BitAutoReloadNoMask
	TIM_InitStructure.TIM_Polity    = PolityHigh;			//指定中断优先级, PolityHigh,PolityLow
	TIM_InitStructure.TIM_Interrupt = ENABLE;				//中断是否允许,   ENABLE或DISABLE
	TIM_InitStructure.TIM_ClkSource = TIM_CLOCK_1T;		    //指定时钟源,     TIM_CLOCK_1T,TIM_CLOCK_12T,TIM_CLOCK_Ext
	TIM_InitStructure.TIM_ClkOut    = DISABLE;				//是否输出高速脉冲, ENABLE或DISABLE
	TIM_InitStructure.TIM_Value     = 65536 - (MAIN_Fosc / (1 * 1000));	//初值, 节拍为1000HZ(1ms)
	TIM_InitStructure.TIM_Run       = ENABLE;				//是否初始化后启动定时器, ENABLE或DISABLE
	Timer_Inilize(Timer1,&TIM_InitStructure);				//初始化Timer0	  Timer0,Timer1,Timer2
    
    /* Timer2 固定用于UART波特率发生器，请勿用作独立定时器 */
    //TIM_InitStructure.TIM_Mode      = TIM_16BitAutoReload;	//指定工作模式,   TIM_16BitAutoReload,TIM_16Bit,TIM_8BitAutoReload,TIM_16BitAutoReloadNoMask
	//TIM_InitStructure.TIM_Polity    = PolityHigh;			//指定中断优先级, PolityHigh,PolityLow
	//TIM_InitStructure.TIM_Interrupt = ENABLE;				//中断是否允许,   ENABLE或DISABLE
	//TIM_InitStructure.TIM_ClkSource = TIM_CLOCK_1T;		    //指定时钟源,     TIM_CLOCK_1T,TIM_CLOCK_12T,TIM_CLOCK_Ext
	//TIM_InitStructure.TIM_ClkOut    = DISABLE;				//是否输出高速脉冲, ENABLE或DISABLE
	//TIM_InitStructure.TIM_Value     = 65536 - (MAIN_Fosc / (1 * 20));	//初值, 节拍为20HZ(50ms)
	//TIM_InitStructure.TIM_Run       = ENABLE;				//是否初始化后启动定时器, ENABLE或DISABLE
	//Timer_Inilize(Timer2,&TIM_InitStructure);				//初始化Timer0	  Timer0,Timer1,Timer2
}

static void MSR_External_Interrupt_Config(void)
{
    //INT0
    EXTI_InitTypeDef	EXTI_InitStructure;					//结构定义

	EXTI_InitStructure.EXTI_Mode      = EXT_MODE_RiseFall;	//中断模式,  	EXT_MODE_RiseFall, EXT_MODE_Fall
	EXTI_InitStructure.EXTI_Polity    = PolityHigh;			//中断优先级,   PolityLow,PolityHigh
	EXTI_InitStructure.EXTI_Interrupt = ENABLE;				//中断允许,     ENABLE或DISABLE
	Ext_Inilize(EXT_INT0,&EXTI_InitStructure);				//初始化INT0	EXT_INT0,EXT_INT1,EXT_INT2,EXT_INT3,EXT_INT4
    
    //EXTI_InitStructure.EXTI_Mode      = EXT_MODE_Fall;	    //中断模式,  	EXT_MODE_RiseFall, EXT_MODE_Fall
	//EXTI_InitStructure.EXTI_Polity    = PolityHigh;			//中断优先级,   PolityLow,PolityHigh
	//EXTI_InitStructure.EXTI_Interrupt = ENABLE;				//中断允许,     ENABLE或DISABLE
	//Ext_Inilize(EXT_INT3,&EXTI_InitStructure);				//初始化INT1	EXT_INT0,EXT_INT1,EXT_INT2,EXT_INT3,EXT_INT4
}

static void SLV_External_Interrupt_Config(void)
{
    //INT0 and INT1
    EXTI_InitTypeDef	EXTI_InitStructure;					//结构定义

	EXTI_InitStructure.EXTI_Mode      = EXT_MODE_RiseFall;	//中断模式,  	EXT_MODE_RiseFall, EXT_MODE_Fall
	EXTI_InitStructure.EXTI_Polity    = PolityHigh;			//中断优先级,   PolityLow,PolityHigh
	EXTI_InitStructure.EXTI_Interrupt = ENABLE;				//中断允许,     ENABLE或DISABLE
	Ext_Inilize(EXT_INT0,&EXTI_InitStructure);				//初始化INT0	EXT_INT0,EXT_INT1,EXT_INT2,EXT_INT3,EXT_INT4

	EXTI_InitStructure.EXTI_Mode      = EXT_MODE_RiseFall;	//中断模式,  	EXT_MODE_RiseFall, EXT_MODE_Fall
	EXTI_InitStructure.EXTI_Polity    = PolityLow;			//中断优先级,   PolityLow,PolityHigh
	EXTI_InitStructure.EXTI_Interrupt = ENABLE;				//中断允许,     ENABLE或DISABLE
	Ext_Inilize(EXT_INT1,&EXTI_InitStructure);				//初始化INT1	EXT_INT0,EXT_INT1,EXT_INT2,EXT_INT3,EXT_INT4
    
    //EXTI_InitStructure.EXTI_Mode      = EXT_MODE_Fall;	    //中断模式,  	EXT_MODE_RiseFall, EXT_MODE_Fall
	//EXTI_InitStructure.EXTI_Polity    = PolityHigh;			//中断优先级,   PolityLow,PolityHigh
	//EXTI_InitStructure.EXTI_Interrupt = ENABLE;				//中断允许,     ENABLE或DISABLE
	//Ext_Inilize(EXT_INT3,&EXTI_InitStructure);				//初始化INT1	EXT_INT0,EXT_INT1,EXT_INT2,EXT_INT3,EXT_INT4
}

#if TEST_MODE
static void doRunning_HardwareTest(void)
{
    u8 i = 0;

    /* Step1: */
    EA = 0; // disbale all interrupt

    if( isMasterDevice()) {
        MSR_GPIO_Config();//GPIO init
        MSR_External_Interrupt_Config();
    } else {
        SLV_GPIO_Config();//GPIO init
        SLV_SPI_Config();
        SLV_External_Interrupt_Config();
    }

    /* Debug Uart(P3.0/P3.1) and MAX485 Uart(P4.6/P4.7) init */
    UART_config();
	Timer_Config();//Timer init

	EA = 1; // enable all interrupt

	PrintSystemInfoToSerial(isMasterDevice()? TRUE : FALSE);
	LOGD("====> %s Device Hardware Init Ok \r\n", isMasterDevice()? "Master" : "Slave");

    //watch dog init
    init_Watch_Dog();
    
    while(1) {
        /* Check RS485 Communication */
        
        /* Check AC Power PhaseSequence  */
        //acPowerPhaseSequenceCheck_Test();

        /* LED Light Hardware Check */
        if(iSecondCounter % 100 == 0) {
            ledLight_Test(LED_OFF);
        } else if(iSecondCounter % 50 == 0) {
            ledLight_Test(LED_ON);
        }
        
        /* LED ShuMaGuan Hardware Check */
        if(iSecondCounter % 8 == 0) {
            LedKeyScan_Test();
        }
        if(iSecondCounter % 100 == 0) {
            LedDisplay_Test(8);
        }
        
        if( isMasterDevice()) {
            /* SD3178 Hardware Check */
            if(iSecondCounter % 1000 == 0) 
                rtcDisplay_Test();
        } else {
            /* HX710 Hardware Check */
            if(iSecondCounter % 1000 == 0) 
                hx710_Test();
            adxl345_Test();
        }
    }
}

#else

static void doRunning_MasterMain(void)
{
    u8 i = 0;
    //u16 keyCode = 0x0;
    KEYCODE_REC_S* curKeyBitCode = getKeyCode();
    KEYCODE_REC_S lastKeyBitCode = {0x0, 0X0};

	MSR_GPIO_Config();//GPIO init
    MSR_External_Interrupt_Config();
    
	EA = 1; // enable all interrupt

	PrintSystemInfoToSerial(TRUE);
	LOGD("====> Master Device Hardware Init Ok \r\n");

	//watch dog init
    init_Watch_Dog();

    /* Read Configure information From eeprom */
    readInitSystemInfo();
    updateRebootCounterInfo();
    //SYS_INFO_S *sysinfo = readSystemInfo();
    
	while(1) {
        /* Step0：Only for Debug */
        //if(curKeyBitCode != lastKeyBitCode ) {
        //    LOGD("KeyCode = 0x%08bx - 0x%08bx\n",lastKeyBitCode, curKeyBitCode);
        //    lastKeyBitCode = curKeyBitCode ;
        //}
        /* Step1: Check AC Power PhaseSequence */
        phaseSeq = checkACPowerPhaseSequence();
#if DEBUG
        if(phaseSeq != 0xFABC) {
#else
        if(phaseSeq == 0xFABC) {
#endif
            MSR_LedStatusCtrl(MSR_LED_LOSS_PHASE, LED_ON);
            if((curKeyBitCode->firstKeyCode == MSR_KEY_BOOT) && (bMSR_PowerKeyLock)) {
                clrKeyStatus(MSR_KEY_ALL);
                MSR_LedStatusCtrl(MSR_LED_POWER_START, LED_ON);
                MSR_relayCtrl_PWR(ON);
                MSR_relayCtrl_WAR(OFF);
                bMSR_PowerKeyLock = 0;// unlock power key
            } else {
                if(bMSR_PowerKeyLock) {// unlock power key
                    clrKeyStatus(MSR_KEY_ALL); 
                    delay_ms(5);              
                    continue;
                }
            }
        } else { /* 反序 或者 缺相*/
            MSR_relayCtrl_PWR(OFF);
            MSR_relayCtrl_WAR(ON);
            MSR_LedFlashCtrl(MSR_LED_LOSS_PHASE);
            bMSR_PowerKeyLock = 1;
            delay_ms(5);
            continue;
        }

        /* Step2: 检查是否按下了停止键 */
        if((curKeyBitCode->firstKeyCode == MSR_KEY_STOP) && (!bMSR_PowerKeyLock)) {
            clrKeyStatus(MSR_KEY_ALL);
            MSR_relayCtrl_PWR(OFF);
            MSR_relayCtrl_WAR(ON);
            MSR_LedStatusCtrl(MSR_LED_ALL, LED_OFF);

            for(i = 0; i < 10; i++) {
                ledDisplayFlashEnable(i, FALSE);
                ledDisplayClose(i); /* Close All display */
            }

            bMSR_PowerKeyLock = 1;
        }

        /* Step3: Check is need Read Device No 判断是否需要进行报号操作 */
        /* 分机已经做过报号操作直接进入下一个状态机 */
        if((curKeyBitCode->firstKeyCode == MSR_KEY_CMUT)
            && (curKeyBitCode->secondKeyCode == MSR_KEY_SYNC)) {
            if(!checkAddrSyncStatus()) { /* 未进行报号操作或者需要重新报号 */            
                MSR_LedFlashCtrl(MSR_LED_COMMUNICAT_INDICAT);
                //slaveDeviceAddrConfigure();
            } else {
                continue;
            }
        }

        /* Step4: 操作模式按键扫描检查 */
        if((curKeyBitCode->firstKeyCode == MSR_KEY_SET)
            && (curKeyBitCode->secondKeyCode == MSR_KEY_CMUT)) {
        //        /* Wait recive Slave device upload device No. and address  */
                MSR_LedFlashCtrl(MSR_LED_COMMUNICAT_INDICAT);
        //        sysStatuMachine = STATUSMACHINE_CTRLMODE;
                clrKeyStatus(MSR_KEY_SET);
                clrKeyStatus(MSR_KEY_CMUT);
        }

        /* Step5: 485通信接收数据解析处理 */

            /* 检查是否收到从机的异常信息 */
            /* 检测到分机上报的紧急停止的报警信号 */
            //if(slaveDeviceError) {
                /* P4.0输出高电位，电源继电器断开。*/
                //MSR_relayCtrl_PWR(OFF);
                /* P4.4输出低电位，报警继电器吸合发出告警信号 */
                //MSR_relayCtrl_WAR(ON);
            //}

        /* Step6: delay 5ms for thread normal running */
        if((curKeyBitCode->firstKeyCode) && (curKeyBitCode->secondKeyCode)) {
            clrKeyStatus(MSR_KEY_ALL);
        }
        delay_ms(5);
    }
}

static void doRunning_SlaveMain(void)
{
    u8 i = 0;

    SLV_GPIO_Config();//GPIO init
    SLV_SPI_Config();
    SLV_External_Interrupt_Config();

	EA = 1; // enable all interrupt

	PrintSystemInfoToSerial(FALSE);
	LOGD("====> Slave Device Hardware Init Ok \r\n");

	//watch dog init
    init_Watch_Dog();

	while(1) {
        /* Step1: Check AC Power PhaseSequence */
        phaseSeq = checkACPowerPhaseSequence();
        if(phaseSeq == 0xFABC) {
            SLV_LedStatusCtrl(SLV_LED_LOSS_PHASE, LED_OFF);
            //bMSR_PowerKeyLock = 0;// unlock power key
        } else { /* 反序 或者 缺相*/
            //MSR_relayCtrl_PWR(OFF);
            //MSR_relayCtrl_WAR(ON);

            //clrKeyStatus(MSR_KEY_BOOT);
            SLV_LedFlashCtrl(SLV_LED_LOSS_PHASE);
            continue;
        }
        
        /* Read HX710 data every 500ms */
        /* Key Scan and process */
	}
}
#endif

void main(void)
{
    /* Step1: */
    EA = 0; // disbale all interrupt

	// Check device is master or slave
    MSR_SLV_CheckGpioConfig();

    /* Debug Uart(P3.0/P3.1) and MAX485 Uart(P4.6/P4.7) init */
    UART_config();
	Timer_Config();//Timer init
    PCA_config(); /* Init for phase check */

#if TEST_MODE
    doRunning_HardwareTest();
#else
	if( isMasterDevice()) {
		doRunning_MasterMain();
	} else {
		doRunning_SlaveMain();
	}
#endif

	//if run to here, system must be reboot now from user space
    Reboot_System();
}
