byxlk/mcupj/docs/example/STC15系列库函数与例程测试版V2.0/例程/28-5个外中断测试/main.c

/*------------------------------------------------------------------*/
/* --- STC MCU International Limited -------------------------------*/
/* --- STC 1T Series MCU RC Demo -----------------------------------*/
/* --- Mobile: (86)13922805190 -------------------------------------*/
/* --- Fax: 86-0513-55012956,55012947,55012969 ---------------------*/
/* --- Tel: 86-0513-55012928,55012929,55012966 ---------------------*/
/* --- Web: www.GXWMCU.com -----------------------------------------*/
/* --- QQ:  800003751 ----------------------------------------------*/
/* If you want to use the program or the program referenced in the  */
/* article, please specify in which data and procedures from STC    */
/*------------------------------------------------------------------*/


#include	"config.h"
#include	"Exti.h"
#include	"timer.h"

/*************	功能说明	**************

测试5个外中断INT0~INT4。
同时从P3.5输出一个1KHZ方波, 可以连接到各个外中断来测试.
INT0(P3.2)配置为上升/下降沿触发, 从INT0输入脉冲, P0.0输出相同频率的脉冲.
INT1(P3.3)配置为上升/下降沿触发, 从INT1输入脉冲, P0.1输出相同频率的脉冲.
INT2(P3.6)固定为下降沿触发, 从INT2输入脉冲, P0.2输出1/2频率的脉冲.
INT3(P3.7)固定为下降沿触发, 从INT3输入脉冲, P0.3输出1/2频率的脉冲.
INT4(P3.0)固定为下降沿触发, 从INT4输入脉冲, P0.4输出1/2频率的脉冲.


******************************************/

/*************	本地常量声明	**************/


/*************	本地变量声明	**************/


/*************	本地函数声明	**************/



/*************  外部函数和变量声明 *****************/

void	EXTI_config(void)
{
	EXTI_InitTypeDef	EXTI_InitStructure;					//结构定义

	EXTI_InitStructure.EXTI_Mode      = EXT_MODE_RiseFall;	//中断模式,  	EXT_MODE_RiseFall, EXT_MODE_Fall
	EXTI_InitStructure.EXTI_Polity    = PolityHigh;			//中断优先级,   PolityLow,PolityHigh
	EXTI_InitStructure.EXTI_Interrupt = ENABLE;				//中断允许,     ENABLE或DISABLE
	Ext_Inilize(EXT_INT0,&EXTI_InitStructure);				//初始化INT0	EXT_INT0,EXT_INT1,EXT_INT2,EXT_INT3,EXT_INT4

	EXTI_InitStructure.EXTI_Mode      = EXT_MODE_RiseFall;	//中断模式,  	EXT_MODE_RiseFall, EXT_MODE_Fall
	EXTI_InitStructure.EXTI_Polity    = PolityLow;			//中断优先级,   PolityLow,PolityHigh
	EXTI_InitStructure.EXTI_Interrupt = ENABLE;				//中断允许,     ENABLE或DISABLE
	Ext_Inilize(EXT_INT1,&EXTI_InitStructure);				//初始化INT1	EXT_INT0,EXT_INT1,EXT_INT2,EXT_INT3,EXT_INT4

	Ext_Inilize(EXT_INT2,&EXTI_InitStructure);				//初始化INT2	EXT_INT0,EXT_INT1,EXT_INT2,EXT_INT3,EXT_INT4
	Ext_Inilize(EXT_INT3,&EXTI_InitStructure);				//初始化INT3	EXT_INT0,EXT_INT1,EXT_INT2,EXT_INT3,EXT_INT4
	Ext_Inilize(EXT_INT4,&EXTI_InitStructure);				//初始化INT4	EXT_INT0,EXT_INT1,EXT_INT2,EXT_INT3,EXT_INT4
}

void	Timer_config(void)
{
	TIM_InitTypeDef		TIM_InitStructure;					//结构定义
	TIM_InitStructure.TIM_Mode      = TIM_16BitAutoReload;	//指定工作模式,   TIM_16BitAutoReload,TIM_16Bit,TIM_8BitAutoReload,TIM_16BitAutoReloadNoMask
	TIM_InitStructure.TIM_Polity    = PolityLow;			//指定中断优先级, PolityHigh,PolityLow
	TIM_InitStructure.TIM_Interrupt = DISABLE;				//中断是否允许,   ENABLE或DISABLE
	TIM_InitStructure.TIM_ClkSource = TIM_CLOCK_1T;			//指定时钟源,     TIM_CLOCK_1T,TIM_CLOCK_12T,TIM_CLOCK_Ext
	TIM_InitStructure.TIM_ClkOut    = ENABLE;				//是否输出高速脉冲, ENABLE或DISABLE
	TIM_InitStructure.TIM_Value     = 65536 - ((500 * Main_Fosc_KHZ) / 1000);	//初值,
	TIM_InitStructure.TIM_Run       = ENABLE;				//是否初始化后启动定时器, ENABLE或DISABLE
	Timer_Inilize(Timer0,&TIM_InitStructure);				//初始化Timer0	  Timer0,Timer1,Timer2
}


/**********************************************/
void main(void)
{
	EXTI_config();
	Timer_config();

	EA = 1;

	while (1)
	{
	}
}
