byxlk/mcupj/(commit log)

2020-12-12 Add newest sch and pcb file
2020-12-15 Add Led control interface support
2021-01-02 Fix uart can't print out logs
    [STC15Fxxxx.H, USART.C, api_config.h, common.c, main.c]
2021-01-02 Fix uart loss data issue
    [USART.C]
2021-01-06 Fix fzh181 can't display issue
    [api_config.h, fzh181.c, main.c]
2021-01-13 Fix key test code issue
    [fzh181.c]
2021-01-20 Add led flash feature support
2021-01-23 fix some issue and update documents
    [USART.h, api_config.h, fzh181.c, main.c, max485.c, phase_detect.c]
2021-01-31 Fix key scan and display issue
    [api_config.h, fzh181.c, led_ctrl.c, main.c, max485.c]
2021-02-08 Fix key press seqence issue
    [api_config.h, fzh181.c, main.c]
2021-02-08 优化代码
2021-02-17 添加测试工程
2021-02-22 优化相序检测算法
2021-03-06 添加参考文档和代码
